essensys-hub/essensys-board-SC942C/docs_generation_prompt.md

# Prompt Template pour la Documentation Automatisée de Modules

Utilisez ce prompt pour générer la structure de documentation pour un nouveau module (ex: SC941C). Copiez-collez ce texte dans votre assistant IA, en fournissant la liste des fichiers de votre dossier.

---

**Contexte**
Je souhaite publier la documentation technique d'un nouveau module hardware (ex: `SC9xx`) pour le projet Open Source **Essensys Atrium**.
Je dispose des fichiers bruts (Export Altium, PDFs, STEP, Gerbers) dans le répertoire courant.
Mon objectif est de créer un site statique **MkDocs** (thème Material) entièrement en **Français** pour permettre aux utilisateurs de visualiser l'architecture et de télécharger les fichiers de fabrication.

**Fichiers disponibles (Input)**
*(Collez ici la liste de vos fichiers, par exemple :)*
- `Schematic PDF.pdf`
- `STEP_forSIxxxx.step`
- `Gerber for SIxxxx.zip`
- `SCxxxx` (Dossier sources)

**Tes instructions :**

1.  **Organisation des Fichiers (Assets)**
    *   Crée l'arborescence `docs/assets/` avec les sous-dossiers : `models/`, `manufacturing/`, `pdfs/`, `images/`.
    *   Renomme et déplace le fichier STEP vers `docs/assets/models/[NOM_MODULE].step`.
    *   Renomme et déplace le fichier ZIP des Gerbers vers `docs/assets/manufacturing/[NOM_MODULE]_Gerbers.zip`.
    *   Renomme et déplace les PDFs (Schéma, Assembly) vers `docs/assets/pdfs/`.
    *   Copie le PDF du schéma à la racine de `docs/assets/` sous le nom `[NOM_MODULE]_Schematic.pdf` pour un accès rapide.

2.  **Génération d'Images (Prévisualisation)**
    *   Si l'outil `pdftoppm` est disponible (ou via python), extrais les pages 2 (MCU) et 8 (Connecteurs) du PDF Schématique en PNG.
    *   Place-les dans `docs/assets/images/` (ex: `schematic_p2.png`).

3.  **Création du contenu Markdown (`docs/`)**
    *   `index.md`: Page d'accueil. Doit contenir :
        *   Une introduction "Open Source Hardware".
        *   La section "Aperçu du schéma" affichant les images générées (p2 et p8).
        *   Une liste des sections avec des émojis **Unicode** (🏛️ Architecture, 🔌 Hardware, 💾 Téléchargements).
    *   `downloads.md`: Page de téléchargements avec un tableau ou liste à cocher pour :
        *   📂 Schéma PDF
        *   📦 Modèle 3D (STEP)
        *   🏭 Fichiers de Fabrication (Gerbers ZIP)
    *   `hardware.md` et `architecture.md`: Crée les fichiers squelettes.

4.  **Documentation Firmware (`docs/firmware.md`)**
    *   Si un dossier de code source est présent (ex: `Prog/source`), analyse :
        *   `main.c`: Point d'entrée et gestion EEPROM.
        *   `hard.h` / `hard.c`: Initialisation matérielle.
        *   **`gestionentrees.c`**: Mapping des entrées (Tables `switch/case` comme `uc_EntreeTOREntreeCarte`).
        *   `slavenode.c`: Protocole de communication et vérification des données envoyées (Est-ce que les entrées sont remontées au maître ?).
    *   Crée `firmware.md` décrivant :
        *   L'environnement de build (Compilateur, MCU).
        *   La structure du projet.
        *   Le mapping mémoire (EEPROM).
        *   **Important**: Analyse et documente le **"Logical to Physical Mapping"** des entrées. Crée un tableau montrant la correspondance entre l'index logique (ex: `VAR0`) et la broche physique (ex: `RG1`). Précise si certaines entrées sont ignorées.
    *   **Diagrammes Mermaid obligatoires** :
        *   Un **Flowchart** (`graph TD`) expliquant la boucle principale et le traitement des interruptions.
        *   Un diagramme montrant le flux de traitement d'une entrée : `Bouton -> Anti-Rebond -> Stockage -> Interprétation -> Action`.
        *   *Attention à la syntaxe* : Mets des guillemets autour des labels contenant des parenthèses ou crochets (ex: `Node["Condition(1)"]`).

5.  **Configuration (`mkdocs.yml`)**
    *   Génère le fichier `mkdocs.yml` complet configuré avec le thème `material` et la structure de navigation correspondante.
    *   Ajoute la configuration `markdown_extensions` pour activer `pymdownx.superfences` et le support **Mermaid**.

6.  **Pipeline CI/CD (`.github/workflows/publish.yml`)**
    *   Crée un workflow GitHub Actions pour déployer la documentation sur GitHub Pages.
    *   Utilise `actions/setup-python`, installe `mkdocs-material` et lance `mkdocs gh-deploy --force`.

7.  **Règles Importantes**
    *   Utilise des **émojis Unicode** directs (ex: 💾) et PAS de shortcodes (ex: `:floppy_disk:`) pour éviter les problèmes de rendu.
    *   Écris tout le contenu strictement en **Français**.
    *   Vérifie bien que le support Mermaid est activé dans `mkdocs.yml`.

---
