essensys-hub/essensys-board-SC942C/docs/downloads.md

# 💾 Téléchargements

Retrouvez ici tous les fichiers de conception et de fabrication pour le module SC942C.

| Ressource | Description | Lien |
| :--- | :--- | :--- |
| **📂 Schéma PDF** | Schématique complet du module | [Télécharger (PDF)](assets/pdfs/SC942C_Schematic.pdf) |
| **📦 Modèle 3D** | Modèle STEP pour l'intégration mécanique | [Télécharger (STEP)](assets/models/SC942C.step) |
| **🏭 Gerbers** | Fichiers de fabrication pour PCB | [Télécharger (ZIP)](assets/manufacturing/SC942C_Gerbers.zip) |
| **📄 Plan d'assemblage** | Dessin d'assemblage des composants | [Télécharger (PDF)](assets/pdfs/SC942C_Assembly.pdf) |
