essensys-hub/essensys-board-SC942C/docs/index.md

# Documentation SC942C

Bienvenue sur la documentation du module **SC942C**.

Ce projet s'inscrit dans la démarche **Open Source Hardware** du projet **Essensys Atrium**.

## Aperçu du schéma

Voici un aperçu de l'architecture électronique du module (Extraits).

### Microcontrôleur (MCU)
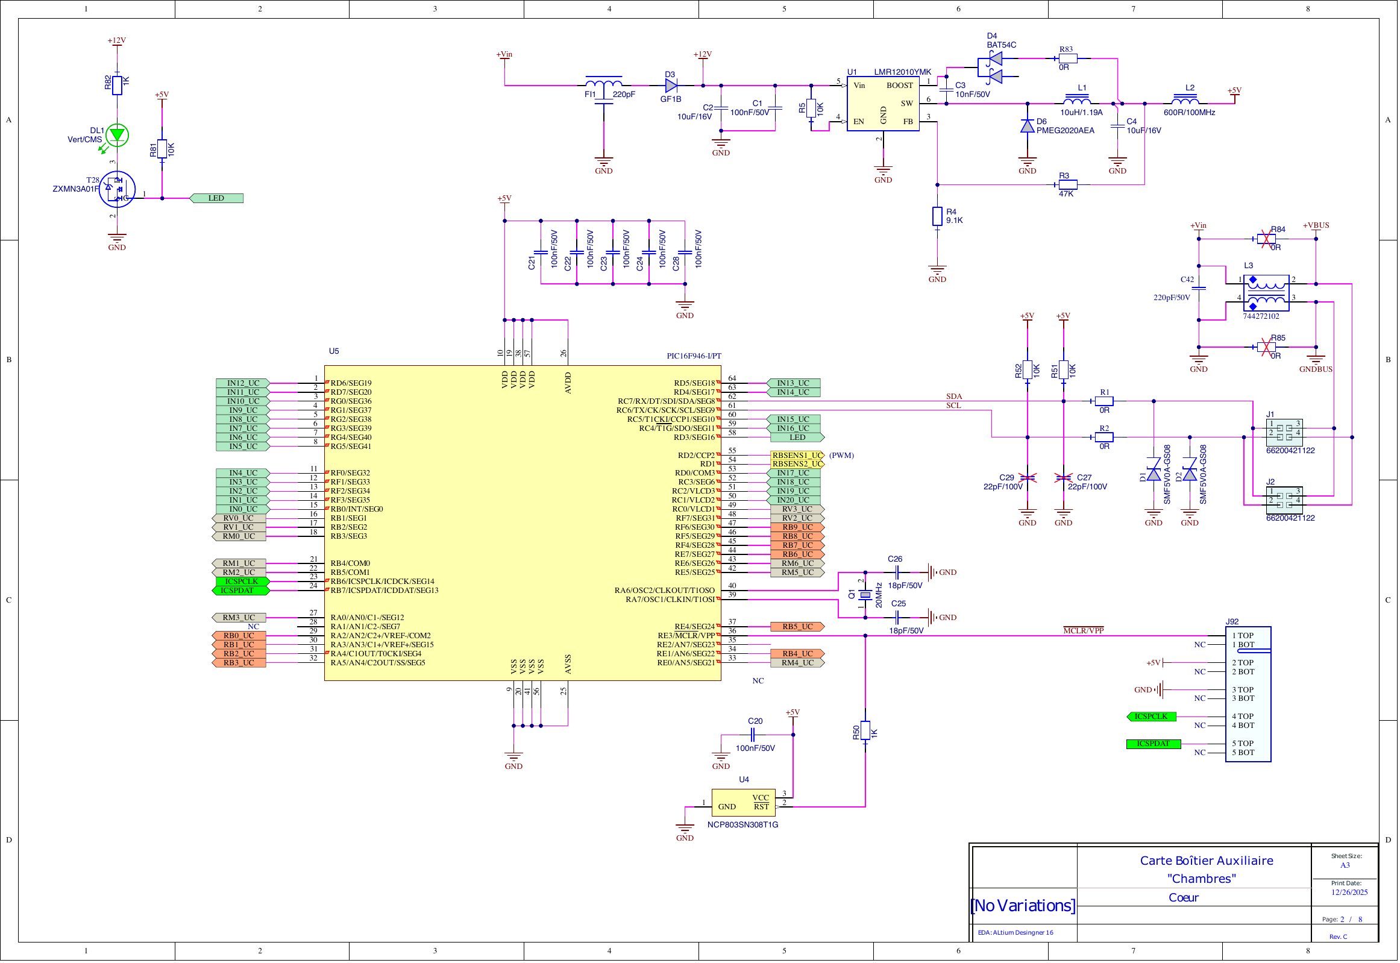
[picture p1: docs/assets/images/schematic_p2.png]
MCU Preview


### Connecteurs
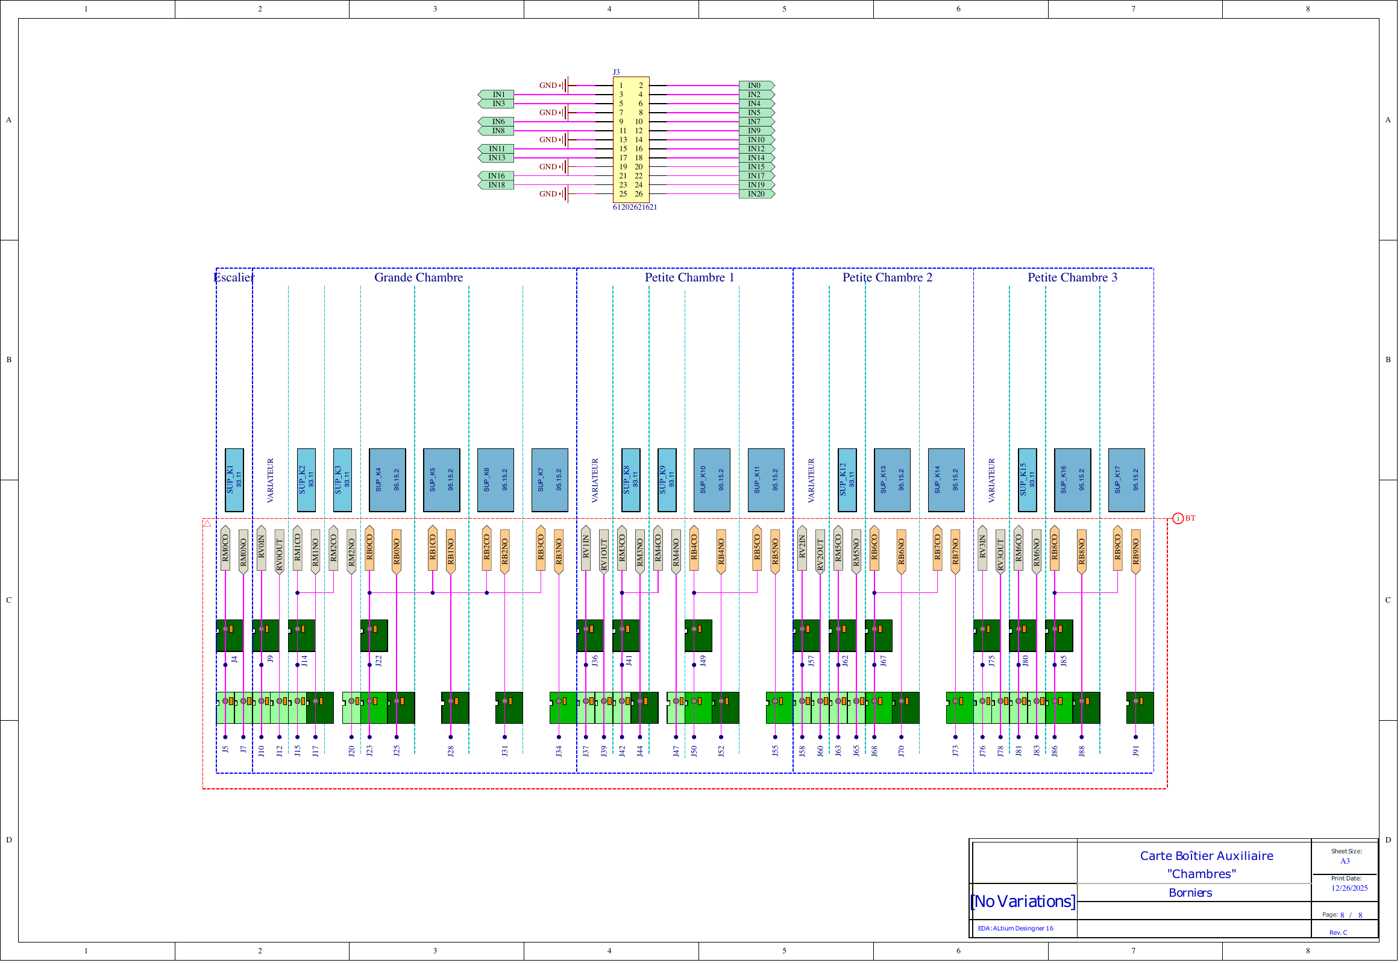
[picture p2: docs/assets/images/schematic_p8.png]
Connectors Preview


## Contenu

*   **[🏛️ Architecture](architecture.md)** : Vue d'ensemble du fonctionnement.
*   **[🔌 Hardware](hardware.md)** : Détails techniques et composants.
*   **[⚙️ Firmware](firmware.md)** : Documentation du code embarqué.
*   **[💾 Téléchargements](downloads.md)** : Fichiers sources (Gerbers, STEP, PDF).
