essensys-hub/essensys-board-SC942C/docs/assets/images/schematic_page-3.png

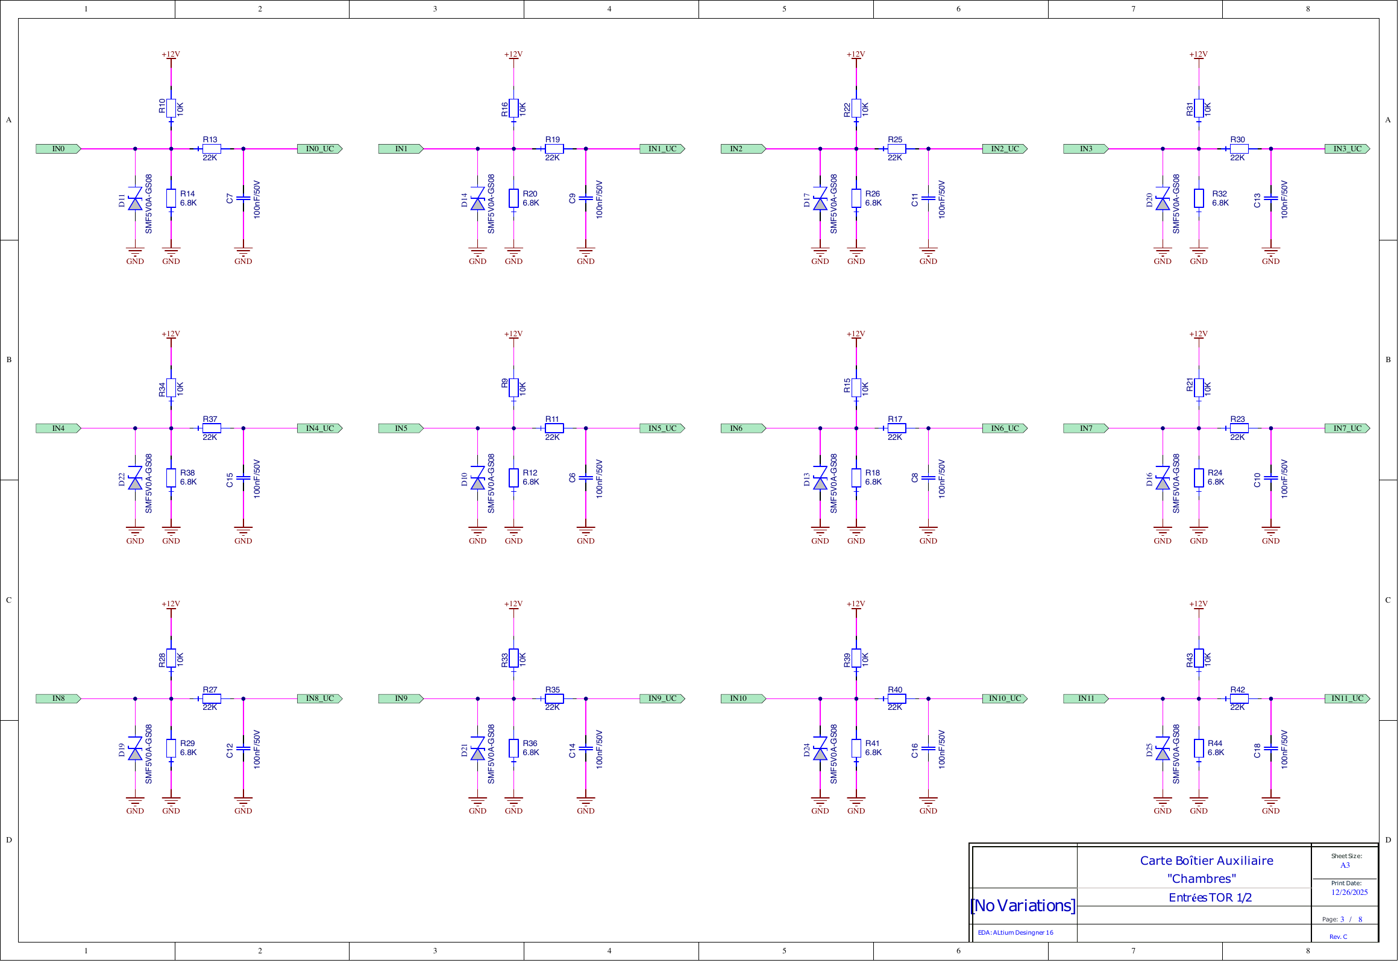
docs/assets/images/schematic_page-3.png
