essensys-hub/essensys-board-SC942C/docs/assets/images/schematic_page-7.png

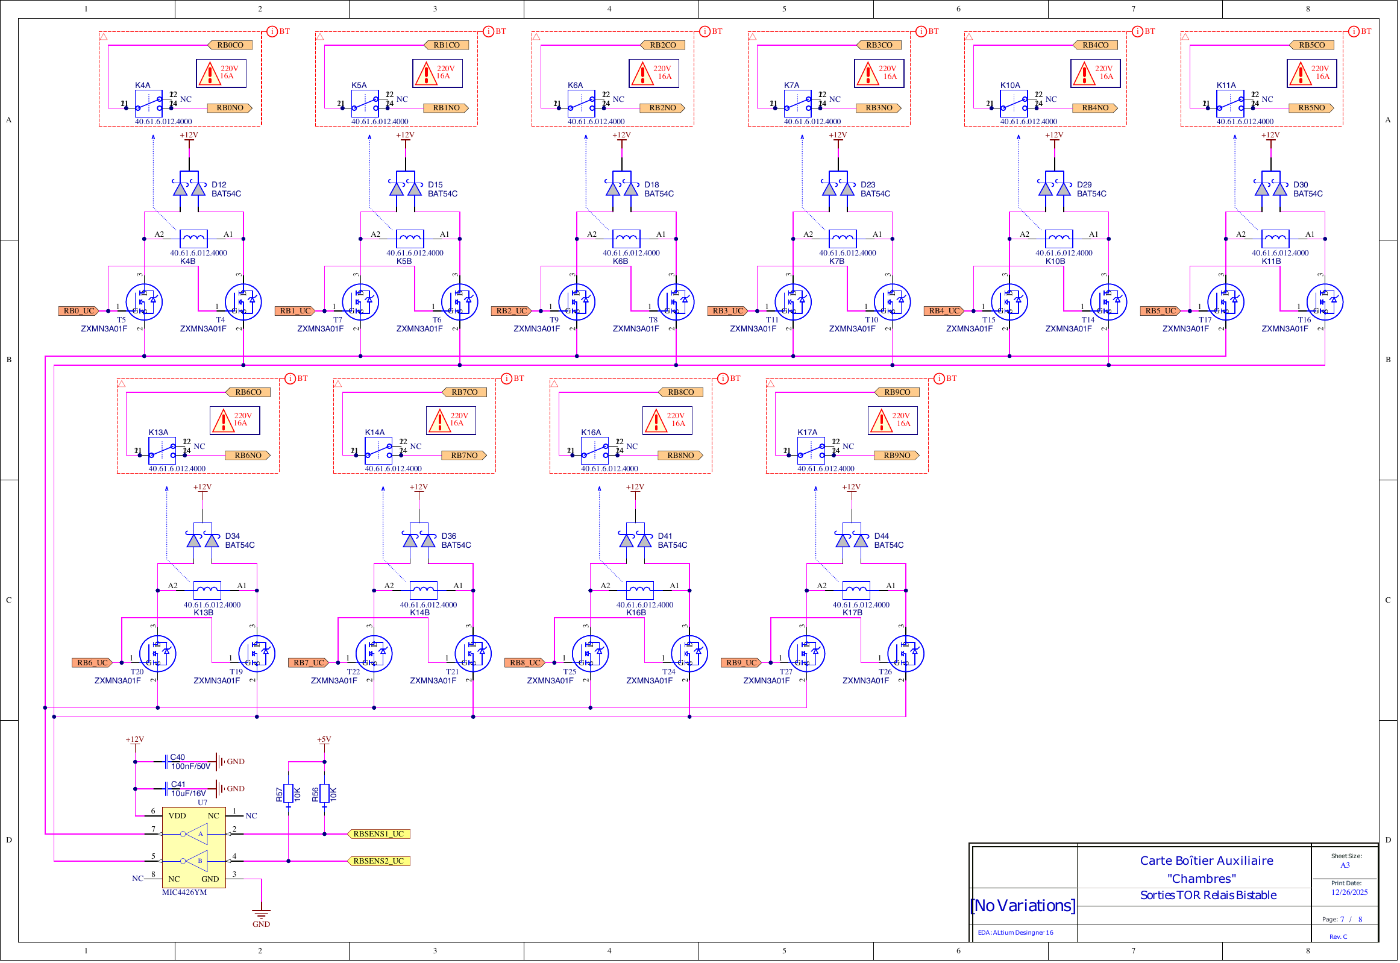
docs/assets/images/schematic_page-7.png
