essensys-hub/essensys-board-SC942C/SC942C/Assembly/SC942C_BOM_Format‚ (DM).xlsx

Description | Fabricant | Ref Fab | Value | Quantity | Designator | Footprint
Circuit imprimé | Valentinéa | SI942C | SI942C | 1 | SI1 | CIRCUIT_IMPRIME_SI_STD
Carte gradateur | Valentinéa | SC943D | - | 4 | U2, U3, U6, U8 | SI943C_REV_A
Résistance CMS 0805, 0.125W, 1%, 100ppm, 150V | Vishay | CRCW08050000Z0EA | 0R | 5 | R1, R2, R83, R84, R85 | 0805_ReflowSoldering_RES
Résistance CMS 0805, 0.125W, 1%, 100ppm, 150V | Vishay | CRCW08051K00FKEA | 1K | 2 | R50, R82 | 0805_ReflowSoldering_RES
Résistance CMS 0805, 0.125W, 1%, 100ppm, 150V | Vishay | CRCW08052K20FKEA | 2.2K | 2 | R75, R78 | 0805_ReflowSoldering_RES
Résistance CMS 0805, 0.125W, 1%, 100ppm, 150V | Vishay | CRCW08056K80FKEA | 6.8K | 21 | R12, R14, R18, R20, R24, R26, R29, R32, R36, R38, R41, R44, R49, R54, R60, R63, R66, R69, R72, R76, R79 | 0805_ReflowSoldering_RES
Résistance CMS 0805, 0.125W, 1%, 100ppm, 150V | Vishay | CRCW08059K10FKEA | 9.1K | 1 | R4 | 0805_ReflowSoldering_RES
Résistance CMS 0805, 0.125W, 1%, 100ppm, 150V | Vishay | CRCW080510K0FKEA | 10K | 34 | R5, R6, R7, R8, R9, R10, R15, R16, R21, R22, R28, R31, R33, R34, R39, R43, R45, R46, R47, R51, R52, R55, R56, R57, R58, R61, R64, R67, R70, R73, R74, R77, R80, R81 | 0805_ReflowSoldering_RES
Résistance CMS 0805, 0.125W, 1%, 100ppm, 150V | Vishay | CRCW080522K0FKEA | 22K | 19 | R11, R13, R17, R19, R23, R25, R27, R30, R35, R37, R40, R42, R48, R53, R59, R62, R65, R68, R71 | 0805_ReflowSoldering_RES
Résistance CMS 0805, 0.125W, 1%, 100ppm, 150V | Vishay | CRCW080547K0FKEA | 47K | 1 | R3 | 0805_ReflowSoldering_RES
Condensateur céramique, NPO, 5%, CMS 0603 | Kemet | C0603C180J5GAC | 18pF/50V | 2 | C25, C26 | 0603_ReflowSoldering_CAP
Condensateur céramique, X7R, 10%, CMS 0603 | Kemet | C0603C103K5RAC | 10nF/50V | 1 | C3 | 0603_ReflowSoldering_CAP
Condensateur céramique, X7R, 10%, CMS 0805 | Kemet | C0805C104K5RAC | 100nF/50V | 33 | C1, C5, C6, C7, C8, C9, C10, C11, C12, C13, C14, C15, C16, C17, C18, C19, C20, C21, C22, C23, C24, C28, C30, C31, C32, C33, C34, C35, C36, C37, C38, C39, C40 | 0805_ReflowSoldering_CAP
Condensateur céramique, X5R, 10%, CMS 0805 | Kemet | C0805C106K4PAC | 10uF/16V | 3 | C2, C4, C41 | 0805_ReflowSoldering_CAP
Inductance bobinée CMS, 10uH +/- 10%, I=1.19A, Rdc=0.095R, SRF=40MHz, -40/+85°C | Wurth Elektronik | 744043100 | 10uH/1,19A | 1 | L1 | SELF_WE-TPC_4.8x4.78_(type4828)
Ferrite multicouches CMS, imp=600R@100MHz, +/-25%, Rdc=100mR, I=2A | Wurth Elektronik | 74279218 | 600R/100MHz | 1 | L2 | 1206_ReflowSoldering_FERRITE
Filtre EMI selfique-capacitif, -20/+50%, 25Vcc/6A, -40/+85°C | Murata | NFE31PT221D1E9L | 220pF | 1 | FI1 | NFE31P
Quartz CMS série HCM49 (équiv HC49/US), -10/+60°C, +/-30ppm, 18pF | Citizen | HCM49 20.000MABJ-UT | 20MHz | 1 | Q1 | QUARTZ_HC49_11.5X5_CMS
Diode de Redressement, Vrrm=100V, If=1A, Vf=1.1V, CMS | Fairchild | GF1B | - | 1 | D3 | DO214BA-P
Diode Schottky double, BAT54 cathode com, Vrrm=30V, If=300mA, Vf=0.4Vmax, CMS | NXP | BAT54C | - | 18 | D4, D7, D8, D9, D12, D15, D18, D23, D26, D28, D29, D30, D32, D34, D36, D40, D41, D44 | SOT23_3L_ReflowSoldering
Diode Schottky, Vrrm=20V, If=2A, Vf=450mV, CMS | NXP | PMEG2020AEA | - | 1 | D6 | SOD323_ReflowSoldering
Diode Transil/TVS unidirectionnelle (A), 200W, 5V, CMS | Vishay | SMF5V0A | - | 23 | D1, D2, D10, D11, D13, D14, D16, D17, D19, D20, D21, D22, D24, D25, D27, D31, D33, D35, D37, D38, D39, D42, D43 | DO219AB-SMF-P_ReflowSoldering
Varistance disque 275Vac, 350Vdc, 33J, Vbreak=430V@1mA, Vclamp=710V@10A, Ipeak=1200A | Wurth Elektronik | 820572711 | 710V | 4 | VR1, VR2, VR3, VR4 | VDR_Serie_820_d7_h13_e5mm
~~LED vert, Vf 2V@20mA, 40mCd, vue 140°, CMS 0805~~ LED vert, Vf 2,2V@20mA, 12mCd, vue 120°, CMS 0805 | ~~Wurth Elektronik~~ Kingbright | ~~150080VS75000~~ KP2012-SGC | - | 1 | DL1 | LED_0805_KPx_Green
Transistor MOSN logique, Vdss=30V, Id=2A, Rdson=0.12R, CMS | Zetex | ZXMN3A01F | - | 28 | T1, T2, T3, T4, T5, T6, T7, T8, T9, T10, T11, T12, T13, T14, T15, T16, T17, T18, T19, T20, T21, T22, T23, T24, T25, T26, T27, T28 | SOT23_3L_ReflowSoldering
Régulateur ajustable step down, 0.8~20V, 1A, Vin=3~20V, -40/+125°C, CMS | National Semiconductor | LMR12010YMK | - | 1 | U1 | SOT23_6L
Superviseur de Reset pour microcontrolleur 3.08V -Pin SOT-23, CMS | ON | NCP803SN308T1G | - | 1 | U4 | SOT23_3L_ReflowSoldering
Dual High-Speed 1.5A MOSFET Driver, CMS | Micrel | MIC4426YM | - | 1 | U7 | SOIC_08_E1,27_L150_ReflowSoldering
Microcontrôleur 8bit | Microchip | PIC16F946-I/PT | - | 1 | U5 | QFP_064_E0,50_10X10MM
Relais 1RT, 12Vdc, série 34.51, Rc=1940R, Sw:250Vac/6A, Ron=? (AgSnO2) | Finder | 34.51.7.012.4010 | - | 7 | K1, K2, K3, K8, K9, K12, K15 | RELAY_FINDER_34.51_+SUPPORT_93
Relais 1RT, 12Vdc, série 40.61.6 (bistable), Rc=900R, Sw:250Vac/16A, Ron=? (AgSnO2) | Finder | 40.61.6.012.4000 | - | 10 | K4, K5, K6, K7, K10, K11, K13, K14, K16, K17 | RELAY_FINDER_40.61_+SUPPORT_95
Suppor série 93 pour relais Finder séries 34, 250V/6A, Bleu | Finder | 93.11 | - | 7 | SUP_K1, SUP_K2, SUP_K3, SUP_K8, SUP_K9, SUP_K12, SUP_K15 | RELAY-SUPPORT_FINDER_SERIE93
Suppor série 95 pour relais Finder séries 40, 250V/10A, Bleu, sans Etrier | Finder | 95.15.2 SMA | - | 10 | SUP_K4, SUP_K5, SUP_K6, SUP_K7, SUP_K10, SUP_K11, SUP_K13, SUP_K14, SUP_K16, SUP_K17 | RELAY-SUPPORT_FINDER_SERIE95
Bornier à connexion par ressorts/déconnexion par levier, série FFKDS/V2, e5.08, 1x1pts, droit, juxtaposable, 320V/15A, AWG22~16, Vert/Orange | Phoenix Contact | 1790348 | - | 18 | J5, J7, J10, J12, J15, J20, J37, J39, J42, J47, J58, J60, J63, J65, J76, J78, J81, J83 | BRESS_FFKDS/V2-5,08_P1.3
Bornier à connexion par ressorts/déconnexion par levier, série FFKDSA/V2, e7.62, 1x1pts, droit, juxtaposable, 500V/17.5A, AWG22~16, Vert/Orange | Phoenix Contact | 1790377 | - | 7 | J23, J34, J50, J55, J68, J73, J86 | BRESS_FFKDSA/V2-7,62_P1.3
Bornier à connexion par ressorts/déconnexion par levier, série FFKDSA1/V2, e7.62, 1x1pts, droit, terminaison, 500V/17.5A, AWG22~16, Vert/Orange | Phoenix Contact | 1790487 | - | 22 | J4, J9, J14, J17, J22, J25, J28, J31, J36, J41, J44, J49, J52, J57, J62, J67, J70, J75, J80, J85, J88, J91 | BRESS_FFKDSA1/V2-7,62_P1.3
26 Positions Header, Shrouded Connector 0.100" (2.54mm) Through Hole Gold | Wurth Elektronik | 61202621621 | - | 1 | J3 | IDC2P54_26P
Embase type Micro Mate-n-Lok, e3mm, 4pts, droit, cont. étamés 20mR, 250V/5A, Iso 1500V, -40/+105°C | Wurth Elektronik | 66200421122 | - | 2 | J1, J2 | MICRO-MATE-N-LOK_WURTH+TYCO_2X02_D
