essensys-hub/essensys-board-SC942C/(list of files, cad)

Other CAD files:
SC942C/3D/SC942C/SUP_K14.sldasm
SC942C/3D/SC942C/C21.sldasm
SC942C/3D/SC942C/C7_1.sldasm
SC942C/3D/SC942C/D14.sldasm
SC942C/3D/SC942C/R11.sldasm
SC942C/3D/SC942C/D39.sldasm
SC942C/3D/SC942C/D35.sldasm
SC942C/3D/SC942C/D26.sldasm
SC942C/3D/SC942C/K12.sldasm
SC942C/3D/SC942C/C37.sldasm
SC942C/3D/SC942C/R28.sldasm
SC942C/3D/SC942C/C11.sldasm
SC942C/3D/SC942C/U1.sldasm
SC942C/3D/SC942C/R73.sldasm
SC942C/3D/SC942C/C29.sldasm
SC942C/3D/SC942C/C26.sldasm
SC942C/3D/SC942C/J57.sldasm
SC942C/3D/SC942C/R76.sldasm
SC942C/3D/SC942C/R70.sldasm
SC942C/3D/SC942C/T18.sldasm
SC942C/3D/SC942C/J5.sldasm
SC942C/3D/SC942C/T3_1.sldasm
SC942C/3D/SC942C/J50.sldasm
SC942C/3D/SC942C/R57.sldasm
SC942C/3D/SC942C/R6.sldasm
SC942C/3D/SC942C/J73.sldasm
SC942C/3D/SC942C/J49.sldasm
SC942C/3D/SC942C/T10.sldasm
SC942C/3D/SC942C/J34.sldasm
SC942C/3D/SC942C/T1.sldasm
SC942C/3D/SC942C/R4.sldasm
SC942C/3D/SC942C/R16.sldasm
SC942C/3D/SC942C/J28.sldasm
SC942C/3D/SC942C/T19.sldasm
SC942C/3D/SC942C/K1.sldasm
SC942C/3D/SC942C/R64.sldasm
SC942C/3D/SC942C/D30.sldasm
SC942C/3D/SC942C/R62.sldasm
SC942C/3D/SC942C/D19.sldasm
SC942C/3D/SC942C/C15.sldasm
SC942C/3D/SC942C/T4.sldasm
SC942C/3D/SC942C/SUP_K6.sldasm
SC942C/3D/SC942C/C42.sldasm
SC942C/3D/SC942C/U1_1.sldasm
SC942C/3D/SC942C/T15.sldasm
SC942C/3D/SC942C/T6.sldasm
SC942C/3D/SC942C/R74.sldasm
SC942C/3D/SC942C/D15.sldasm
SC942C/3D/SC942C/R37.sldasm
SC942C/3D/SC942C/T22.sldasm
SC942C/3D/SC942C/T27.sldasm
SC942C/3D/SC942C/J25.sldasm
SC942C/3D/SC942C/R26.sldasm
SC942C/3D/SC942C/C2.sldasm
SC942C/3D/SC942C/R33.sldasm
SC942C/3D/SC942C/D25.sldasm
SC942C/3D/SC942C/J7.sldasm
SC942C/3D/SC942C/R56.sldasm
SC942C/3D/SC942C/C36.sldasm
SC942C/3D/SC942C/VR2.sldasm
SC942C/3D/SC942C/VR3.sldasm
SC942C/3D/SC942C/R11_1.sldasm
SC942C/3D/SC942C/K11.sldasm
SC942C/3D/SC942C/J10.sldasm
SC942C/3D/SC942C/C27.sldasm
SC942C/3D/SC942C/L2.sldasm
SC942C/3D/SC942C/T21.sldasm
SC942C/3D/SC942C/D36.sldasm
SC942C/3D/SC942C/J86.sldasm
SC942C/3D/SC942C/C10.sldasm
SC942C/3D/SC942C/R55.sldasm
SC942C/3D/SC942C/J91.sldasm
SC942C/3D/SC942C/R77.sldasm
SC942C/3D/SC942C/J36.sldasm
SC942C/3D/SC942C/D6_1.sldasm
SC942C/3D/SC942C/D3.sldasm
SC942C/3D/SC942C/C17.sldasm
SC942C/3D/SC942C/R83.sldasm
SC942C/3D/SC942C/T7.sldasm
SC942C/3D/SC942C/J42.sldasm
SC942C/3D/SC942C/D34.sldasm
SC942C/3D/SC942C/R18_1.sldasm
SC942C/3D/SC942C/D22.sldasm
SC942C/3D/SC942C/D20.sldasm
SC942C/3D/SC942C/R31.sldasm
SC942C/3D/SC942C/SUP_K10.sldasm
SC942C/3D/SC942C/R20.sldasm
SC942C/3D/SC942C/T12.sldasm
SC942C/3D/SC942C/C40.sldasm
SC942C/3D/SC942C/T25.sldasm
SC942C/3D/SC942C/R84.sldasm
SC942C/3D/SC942C/C8.sldasm
SC942C/3D/SC942C/Q1.sldasm
SC942C/3D/SC942C/J17.sldasm
SC942C/3D/SC942C/STEP-61202621621-rev1.sldasm
SC942C/3D/SC942C/J68.sldasm
SC942C/3D/SC942C/J81.sldasm
SC942C/3D/SC942C/J23.sldasm
SC942C/3D/SC942C/T28.sldasm
SC942C/3D/SC942C/R43.sldasm
SC942C/3D/SC942C/K10.sldasm
SC942C/3D/SC942C/T2.sldasm
SC942C/3D/SC942C/R42.sldasm
SC942C/3D/SC942C/K9.sldasm
SC942C/3D/SC942C/R25.sldasm
SC942C/3D/SC942C/C5.sldasm
SC942C/3D/SC942C/R80.sldasm
SC942C/3D/SC942C/R48.sldasm
SC942C/3D/SC942C/K17.sldasm
SC942C/3D/SC942C/J4.sldasm
SC942C/3D/SC942C/K5.sldasm
SC942C/3D/SC942C/R41.sldasm
SC942C/3D/SC942C/T5_1.sldasm
SC942C/3D/SC942C/R23.sldasm
SC942C/3D/SC942C/K14.sldasm
SC942C/3D/SC942C/D12.sldasm
SC942C/3D/SC942C/R22.sldasm
SC942C/3D/SC942C/VR1.sldasm
SC942C/3D/SC942C/D9.sldasm
SC942C/3D/SC942C/R82.sldasm
SC942C/3D/SC942C/C14.sldasm
SC942C/3D/SC942C/D17.sldasm
SC942C/3D/SC942C/D37.sldasm
SC942C/3D/SC942C/D42.sldasm
SC942C/3D/SC942C/C23.sldasm
SC942C/3D/SC942C/User_Library-SOIC-8-150.sldasm
SC942C/3D/SC942C/J88.sldasm
SC942C/3D/SC942C/J41.sldasm
SC942C/3D/SC942C/J76.sldasm
SC942C/3D/SC942C/R2.sldasm
SC942C/3D/SC942C/D13.sldasm
SC942C/3D/SC942C/T26.sldasm
SC942C/3D/SC942C/R21.sldasm
SC942C/3D/SC942C/D24.sldasm
SC942C/3D/SC942C/D10.sldasm
SC942C/3D/SC942C/C34.sldasm
SC942C/3D/SC942C/R79.sldasm
SC942C/3D/SC942C/J12.sldasm
SC942C/3D/SC942C/R58.sldasm
SC942C/3D/SC942C/R7.sldasm
SC942C/3D/SC942C/U6.sldasm
SC942C/3D/SC942C/T5.sldasm
SC942C/3D/SC942C/K6.sldasm
SC942C/3D/SC942C/R49.sldasm
SC942C/3D/SC942C/STEP-744272102-rev1_RGB8421504.sldasm
SC942C/3D/SC942C/R67.sldasm
SC942C/3D/SC942C/SUP_K11.sldasm
SC942C/3D/SC942C/R19.sldasm
SC942C/3D/SC942C/R13.sldasm
SC942C/3D/SC942C/K4.sldasm
SC942C/3D/SC942C/1151710376.sldasm
SC942C/3D/SC942C/1151710512.sldasm
SC942C/3D/SC942C/1151724792.sldasm
SC942C/3D/SC942C/1151724928.sldasm
SC942C/3D/SC942C/1151725064.sldasm
SC942C/3D/SC942C/1790348.sldasm
SC942C/3D/SC942C/1790377.sldasm
SC942C/3D/SC942C/1790487.sldasm
SC942C/3D/SC942C/61202621621.sldprt
SC942C/3D/SC942C/6120xx21621_PIN.sldprt
SC942C/3D/SC942C/905269392.sldasm
SC942C/3D/SC942C/905269800.sldasm
SC942C/3D/SC942C/Base.sldprt
SC942C/3D/SC942C/Base_4.sldprt
SC942C/3D/SC942C/Base_6.sldprt
SC942C/3D/SC942C/Board.sldprt
SC942C/3D/SC942C/Board_1.sldprt
SC942C/3D/SC942C/C1.sldasm
SC942C/3D/SC942C/C12.sldasm
SC942C/3D/SC942C/C13.sldasm
SC942C/3D/SC942C/C16.sldasm
SC942C/3D/SC942C/C18.sldasm
SC942C/3D/SC942C/C19.sldasm
SC942C/3D/SC942C/C1_1.sldasm
SC942C/3D/SC942C/C20.sldasm
SC942C/3D/SC942C/C22.sldasm
SC942C/3D/SC942C/C24.sldasm
SC942C/3D/SC942C/C25.sldasm
SC942C/3D/SC942C/C28.sldasm
SC942C/3D/SC942C/C2_1.sldasm
SC942C/3D/SC942C/C3.sldasm
SC942C/3D/SC942C/C30.sldasm
SC942C/3D/SC942C/C31.sldasm
SC942C/3D/SC942C/C32.sldasm
SC942C/3D/SC942C/C33.sldasm
SC942C/3D/SC942C/C35.sldasm
SC942C/3D/SC942C/C38.sldasm
SC942C/3D/SC942C/C39.sldasm
SC942C/3D/SC942C/C3_1.sldasm
SC942C/3D/SC942C/C4.sldasm
SC942C/3D/SC942C/C41.sldasm
SC942C/3D/SC942C/C4_1.sldasm
SC942C/3D/SC942C/C5_1.sldasm
SC942C/3D/SC942C/C6.sldasm
SC942C/3D/SC942C/C6_1.sldasm
SC942C/3D/SC942C/C7.sldasm
SC942C/3D/SC942C/C8_1.sldasm
SC942C/3D/SC942C/C9.sldasm
SC942C/3D/SC942C/C9_1.sldasm
SC942C/3D/SC942C/Contact.sldprt
SC942C/3D/SC942C/Coque_inf‚rieure_commune_BA+BP_v3.0_(Valla).sldprt
SC942C/3D/SC942C/Coque_sup‚rieure_BA_CHB_(942)_v2.0_(Valla).sldprt
SC942C/3D/SC942C/D1.sldasm
SC942C/3D/SC942C/D11.sldasm
SC942C/3D/SC942C/D16.sldasm
SC942C/3D/SC942C/D18.sldasm
SC942C/3D/SC942C/D1_1.sldasm
SC942C/3D/SC942C/D2.sldasm
SC942C/3D/SC942C/D21.sldasm
SC942C/3D/SC942C/D23.sldasm
SC942C/3D/SC942C/D27.sldasm
SC942C/3D/SC942C/D28.sldasm
SC942C/3D/SC942C/D29.sldasm
SC942C/3D/SC942C/D2_1.sldasm
SC942C/3D/SC942C/D31.sldasm
SC942C/3D/SC942C/D32.sldasm
SC942C/3D/SC942C/D33.sldasm
SC942C/3D/SC942C/D38.sldasm
SC942C/3D/SC942C/D3_1.sldasm
SC942C/3D/SC942C/D4.sldasm
SC942C/3D/SC942C/D40.sldasm
SC942C/3D/SC942C/D41.sldasm
SC942C/3D/SC942C/D43.sldasm
SC942C/3D/SC942C/D44.sldasm
SC942C/3D/SC942C/D4_1.sldasm
SC942C/3D/SC942C/D5.sldasm
SC942C/3D/SC942C/D6.sldasm
SC942C/3D/SC942C/D7.sldasm
SC942C/3D/SC942C/D7_1.sldasm
SC942C/3D/SC942C/D8.sldasm
SC942C/3D/SC942C/DL1.sldasm
SC942C/3D/SC942C/Extruded.sldprt
SC942C/3D/SC942C/Extruded_1.sldprt
SC942C/3D/SC942C/Extruded_2.sldprt
SC942C/3D/SC942C/Extruded_3.sldprt
SC942C/3D/SC942C/Extruded_4.sldprt
SC942C/3D/SC942C/Extruded_5.sldprt
SC942C/3D/SC942C/Extruded_6.sldprt
SC942C/3D/SC942C/Free-Models.sldasm
SC942C/3D/SC942C/J1.sldasm
SC942C/3D/SC942C/J14.sldasm
SC942C/3D/SC942C/J15.sldasm
SC942C/3D/SC942C/J2.sldasm
SC942C/3D/SC942C/J20.sldasm
SC942C/3D/SC942C/J22.sldasm
SC942C/3D/SC942C/J3.sldasm
SC942C/3D/SC942C/J31.sldasm
SC942C/3D/SC942C/J37.sldasm
SC942C/3D/SC942C/J39.sldasm
SC942C/3D/SC942C/J44.sldasm
SC942C/3D/SC942C/J47.sldasm
SC942C/3D/SC942C/J52.sldasm
SC942C/3D/SC942C/J55.sldasm
SC942C/3D/SC942C/J58.sldasm
SC942C/3D/SC942C/J60.sldasm
SC942C/3D/SC942C/J62.sldasm
SC942C/3D/SC942C/J63.sldasm
SC942C/3D/SC942C/J65.sldasm
SC942C/3D/SC942C/J67.sldasm
SC942C/3D/SC942C/J70.sldasm
SC942C/3D/SC942C/J75.sldasm
SC942C/3D/SC942C/J78.sldasm
SC942C/3D/SC942C/J80.sldasm
SC942C/3D/SC942C/J83.sldasm
SC942C/3D/SC942C/J85.sldasm
SC942C/3D/SC942C/J9.sldasm
SC942C/3D/SC942C/K13.sldasm
SC942C/3D/SC942C/K15.sldasm
SC942C/3D/SC942C/K16.sldasm
SC942C/3D/SC942C/K2.sldasm
SC942C/3D/SC942C/K3.sldasm
SC942C/3D/SC942C/K7.sldasm
SC942C/3D/SC942C/K8.sldasm
SC942C/3D/SC942C/L1.sldasm
SC942C/3D/SC942C/L1_1.sldasm
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
