essensys-hub/essensys-board-SC942C/SC942C/Test/Sources/10 - 20170313_111045.jpg

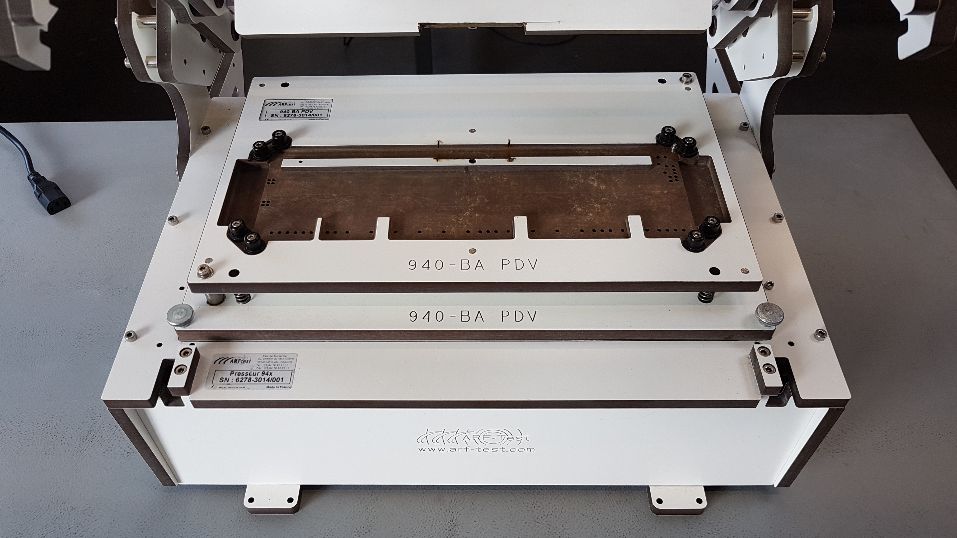
SC942C/Test/Sources/10 - 20170313_111045.jpg
