essensys-hub/essensys-board-SC942C/SC942C/Test/Sources/20 - 20170313_110935.jpg

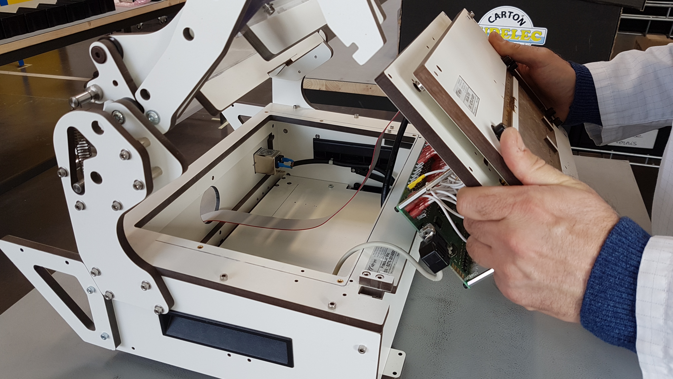
SC942C/Test/Sources/20 - 20170313_110935.jpg
