essensys-hub/essensys-board-SC942C/SC942C/Test/Sources/30 - 20170313_105927.jpg

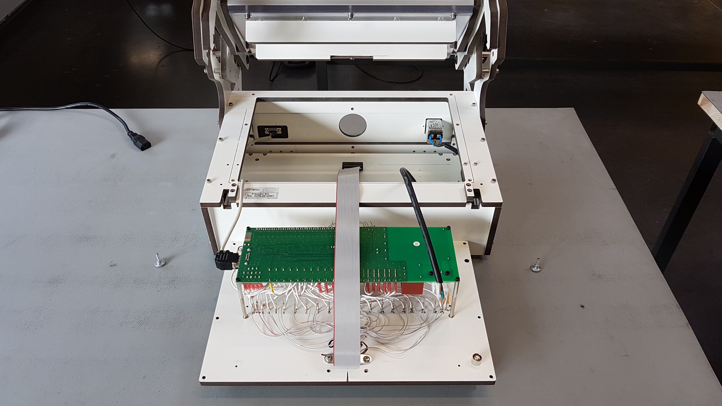
SC942C/Test/Sources/30 - 20170313_105927.jpg
