essensys-hub/essensys-board-SC942C/SC942C/Test/Sources/40 - 20170313_112822.jpg

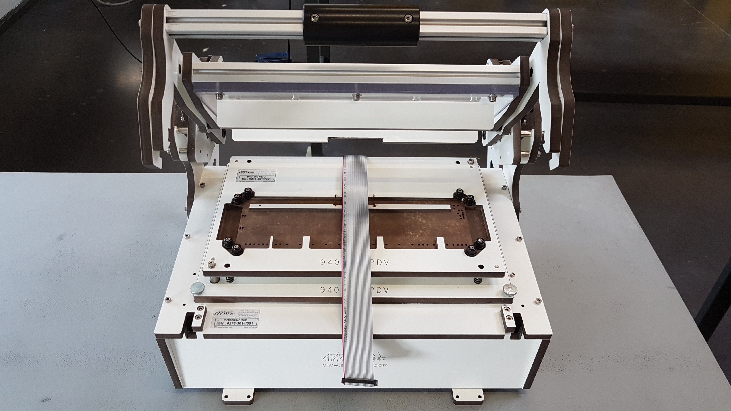
SC942C/Test/Sources/40 - 20170313_112822.jpg
