essensys-hub/essensys-board-SC942C/SC942C/Test/Sources/60 - 20170313_120900.jpg

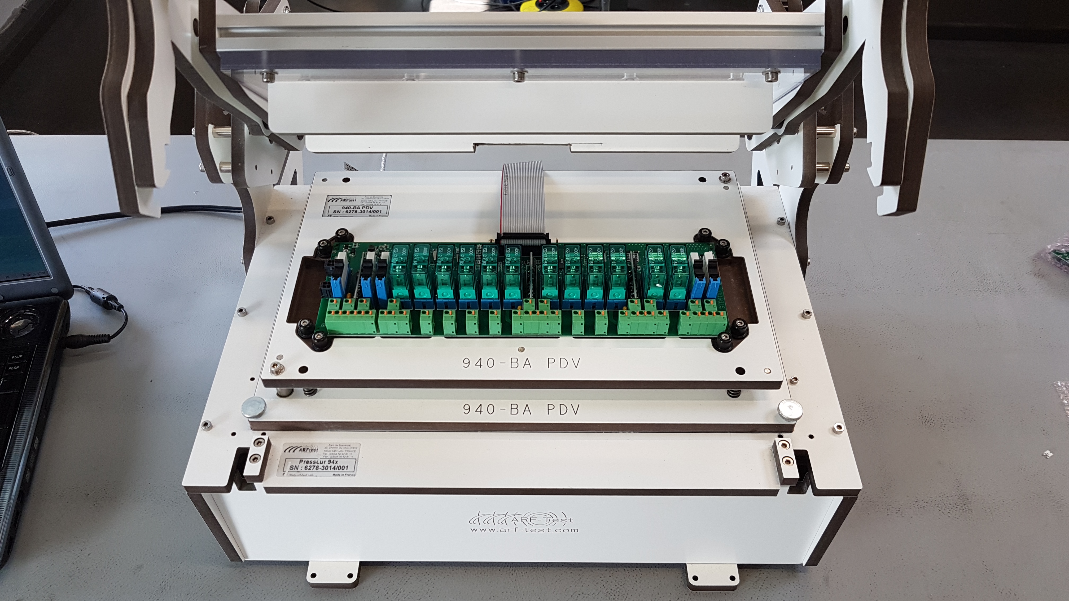
SC942C/Test/Sources/60 - 20170313_120900.jpg
