essensys-hub/essensys-board-SC942C/SC942C/Test/Sources/70 - 20170313_121427.jpg

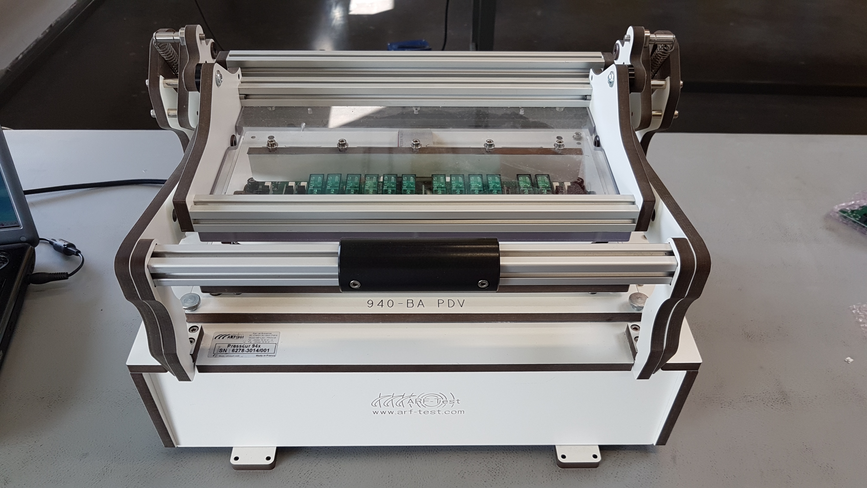
SC942C/Test/Sources/70 - 20170313_121427.jpg
