essensys-hub/essensys-board-SC942C/docs/assets/SC942C_Schematic.pdf

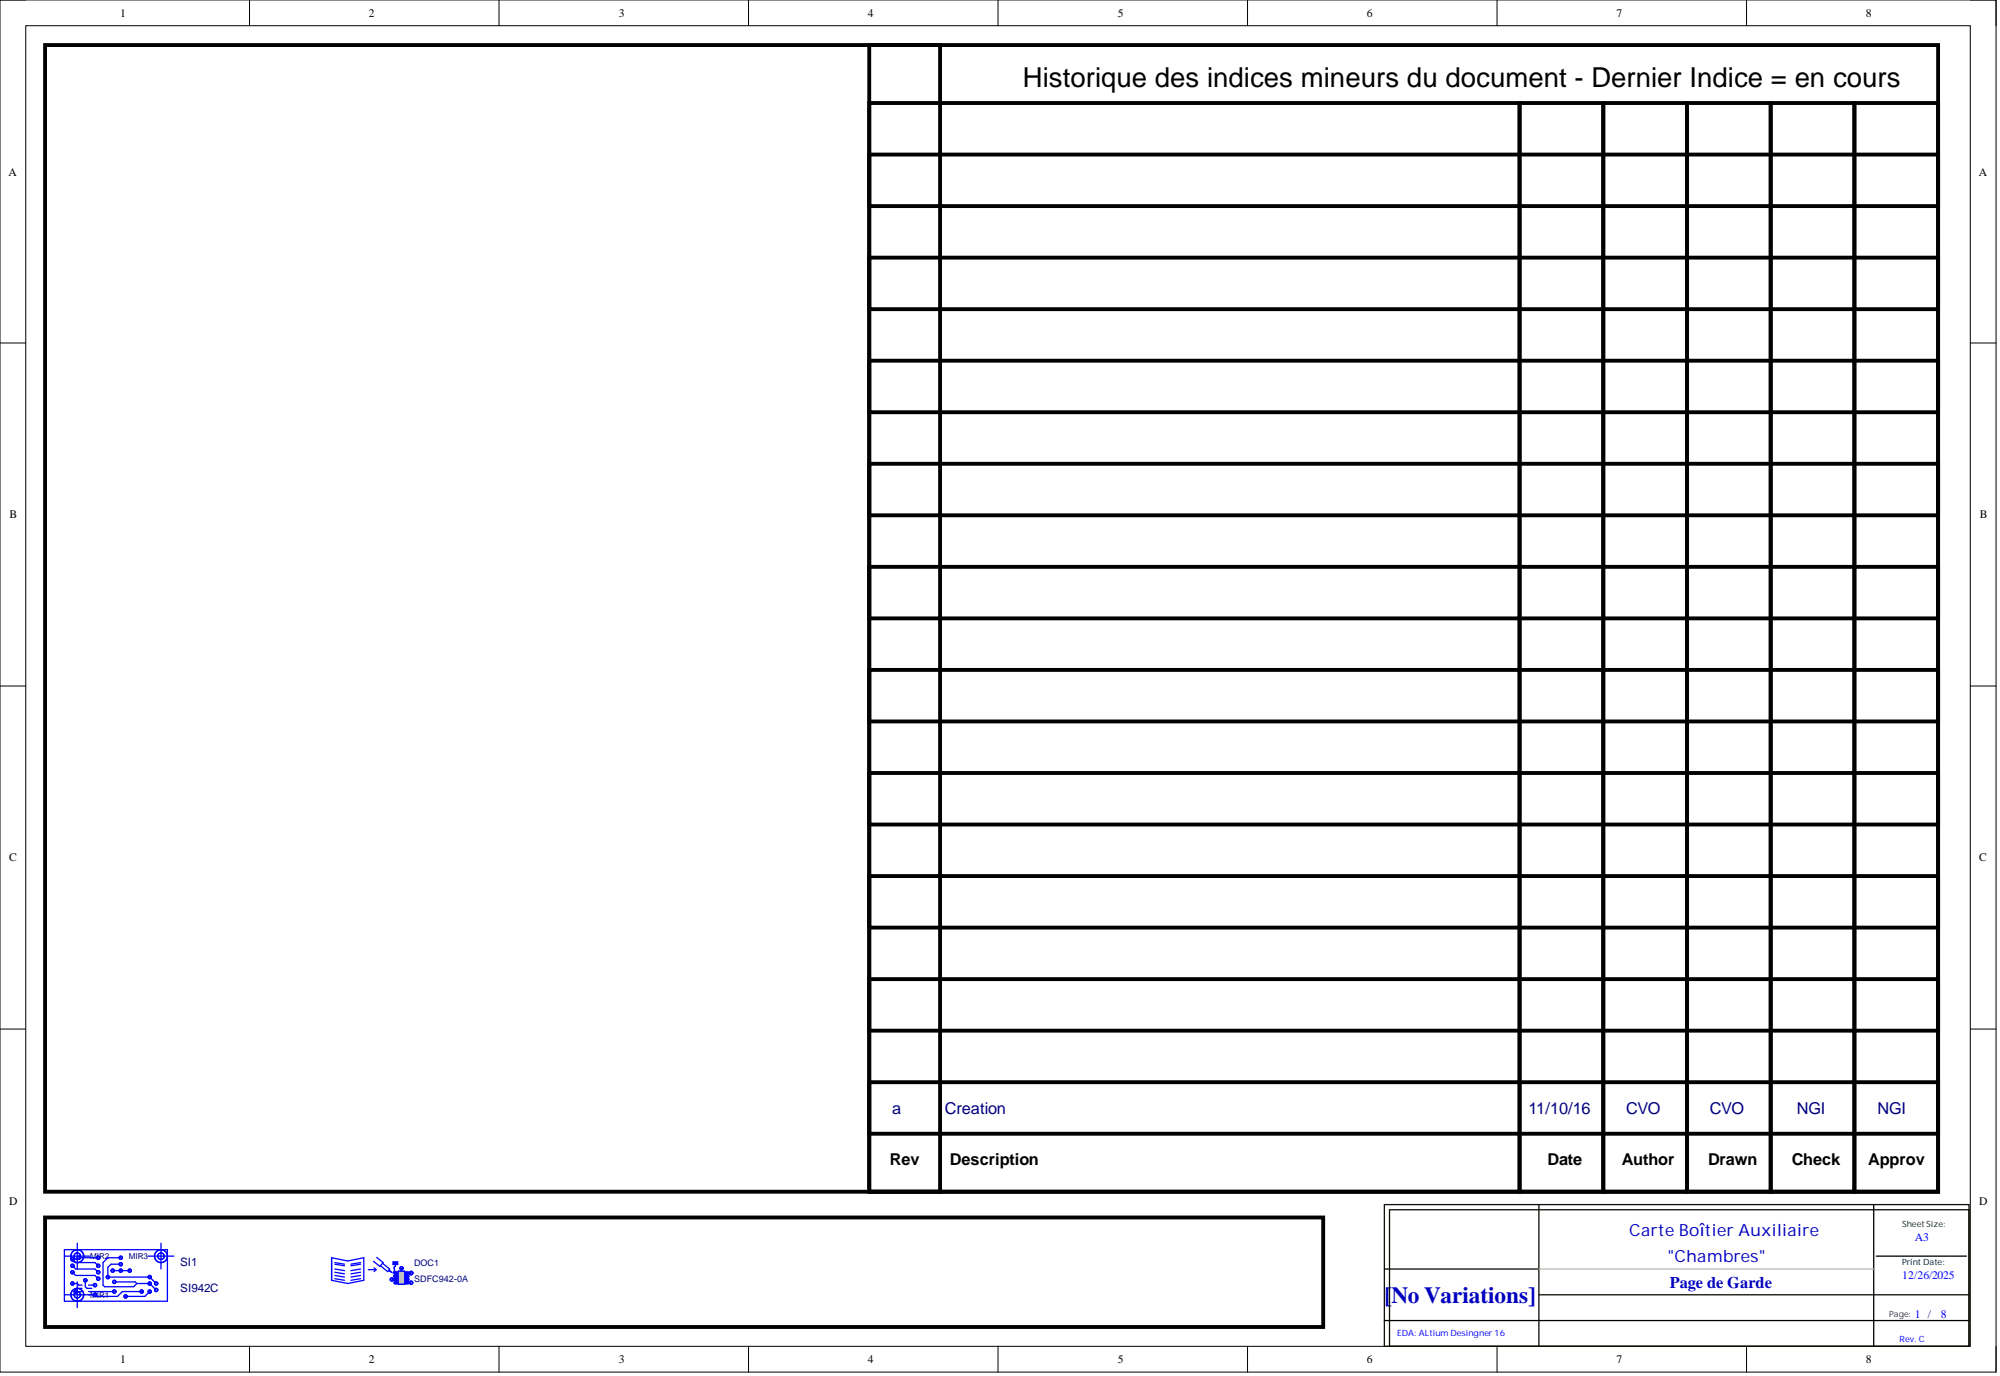
[picture p16: page 1]
t Date:; bres" CODOC1

Historique des indices mineurs du document - Dernier Indice = en cours

a | Creat i o n | 11/10/ 1 6 | C V O | C V O | N G I | N G I

Rev | Descripti o n | Dat e | Autho r | Draw n | Check | Approv

[No Variations] | Page de Garde

Pag e: /

EDA: ALti u m Desi n g ner | | Rev. C

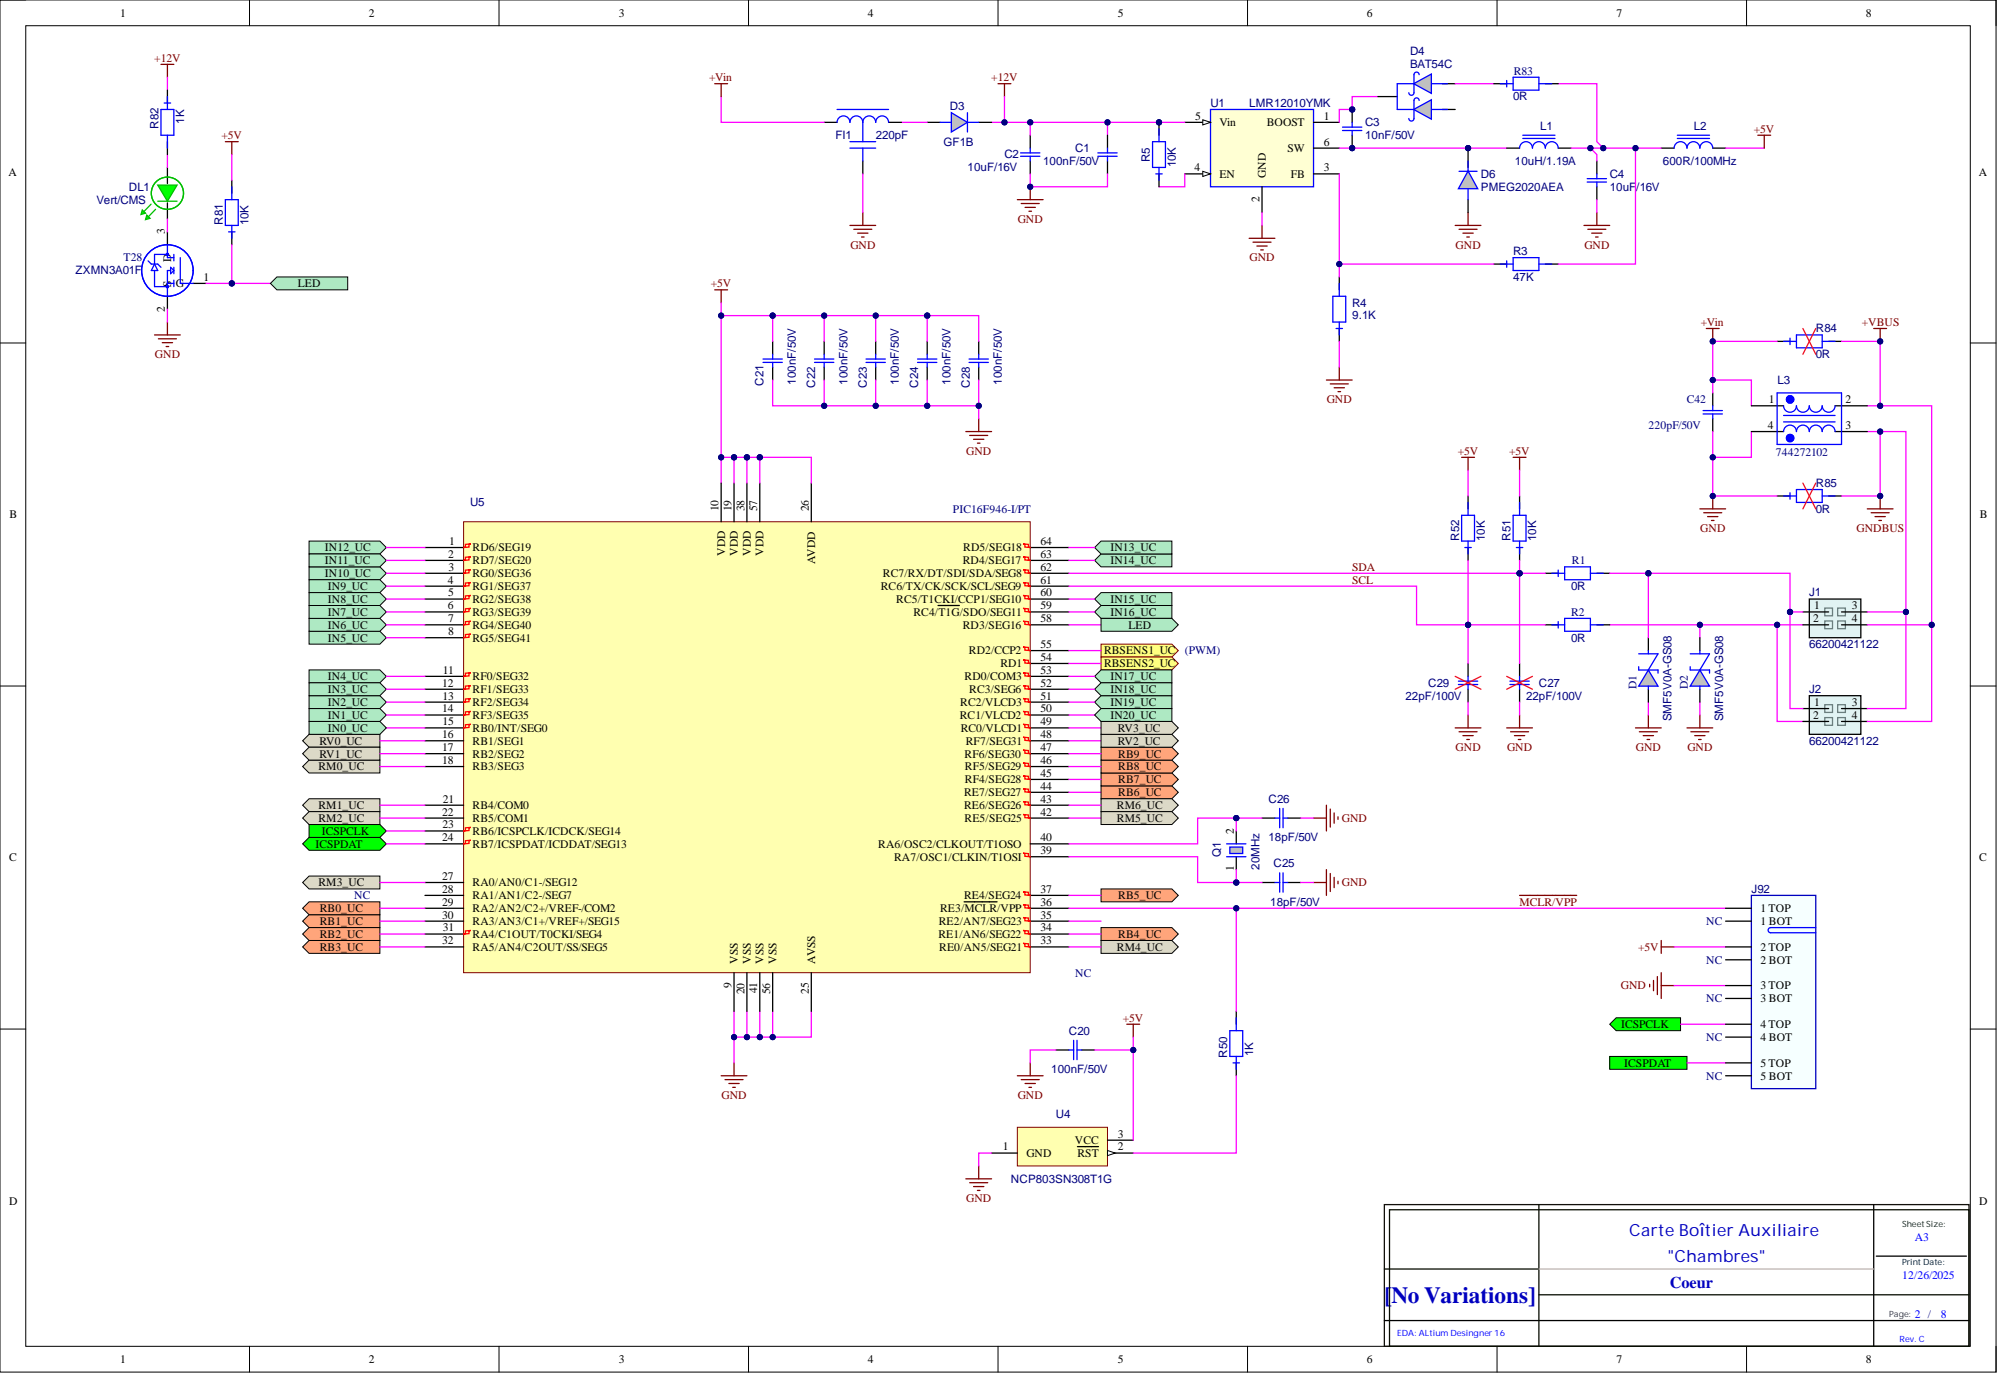
[picture p17: page 2]

SCL

Coeur

Pag e: /

EDA: ALti u m Desi n g ner | | Rev. C

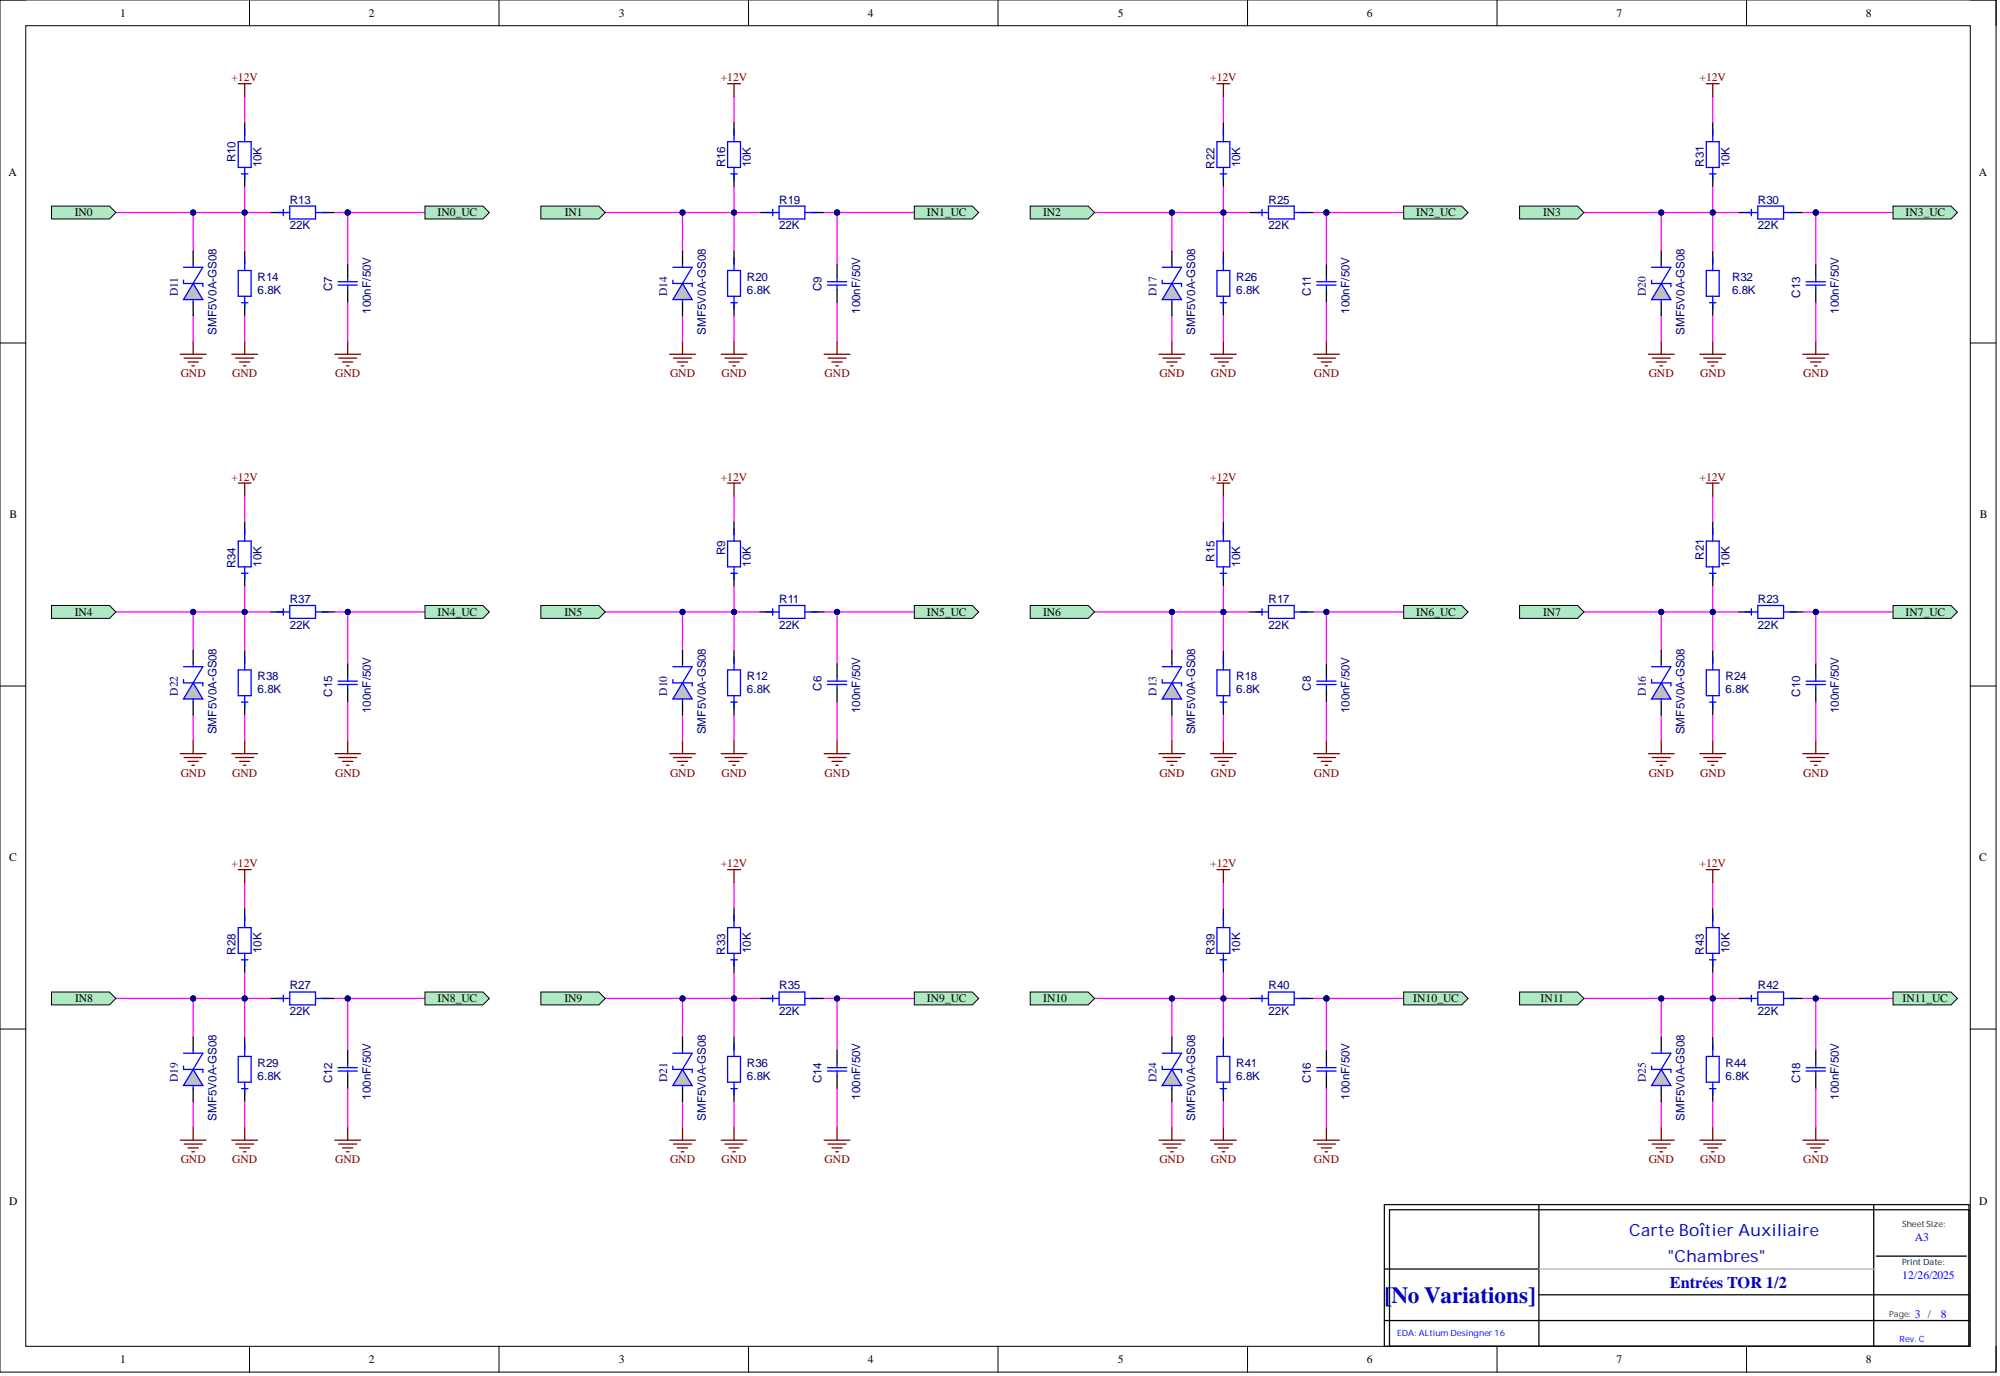
[picture p18: page 3]

Page:

EDA: ALtium Desingner 16 | | Rev. C

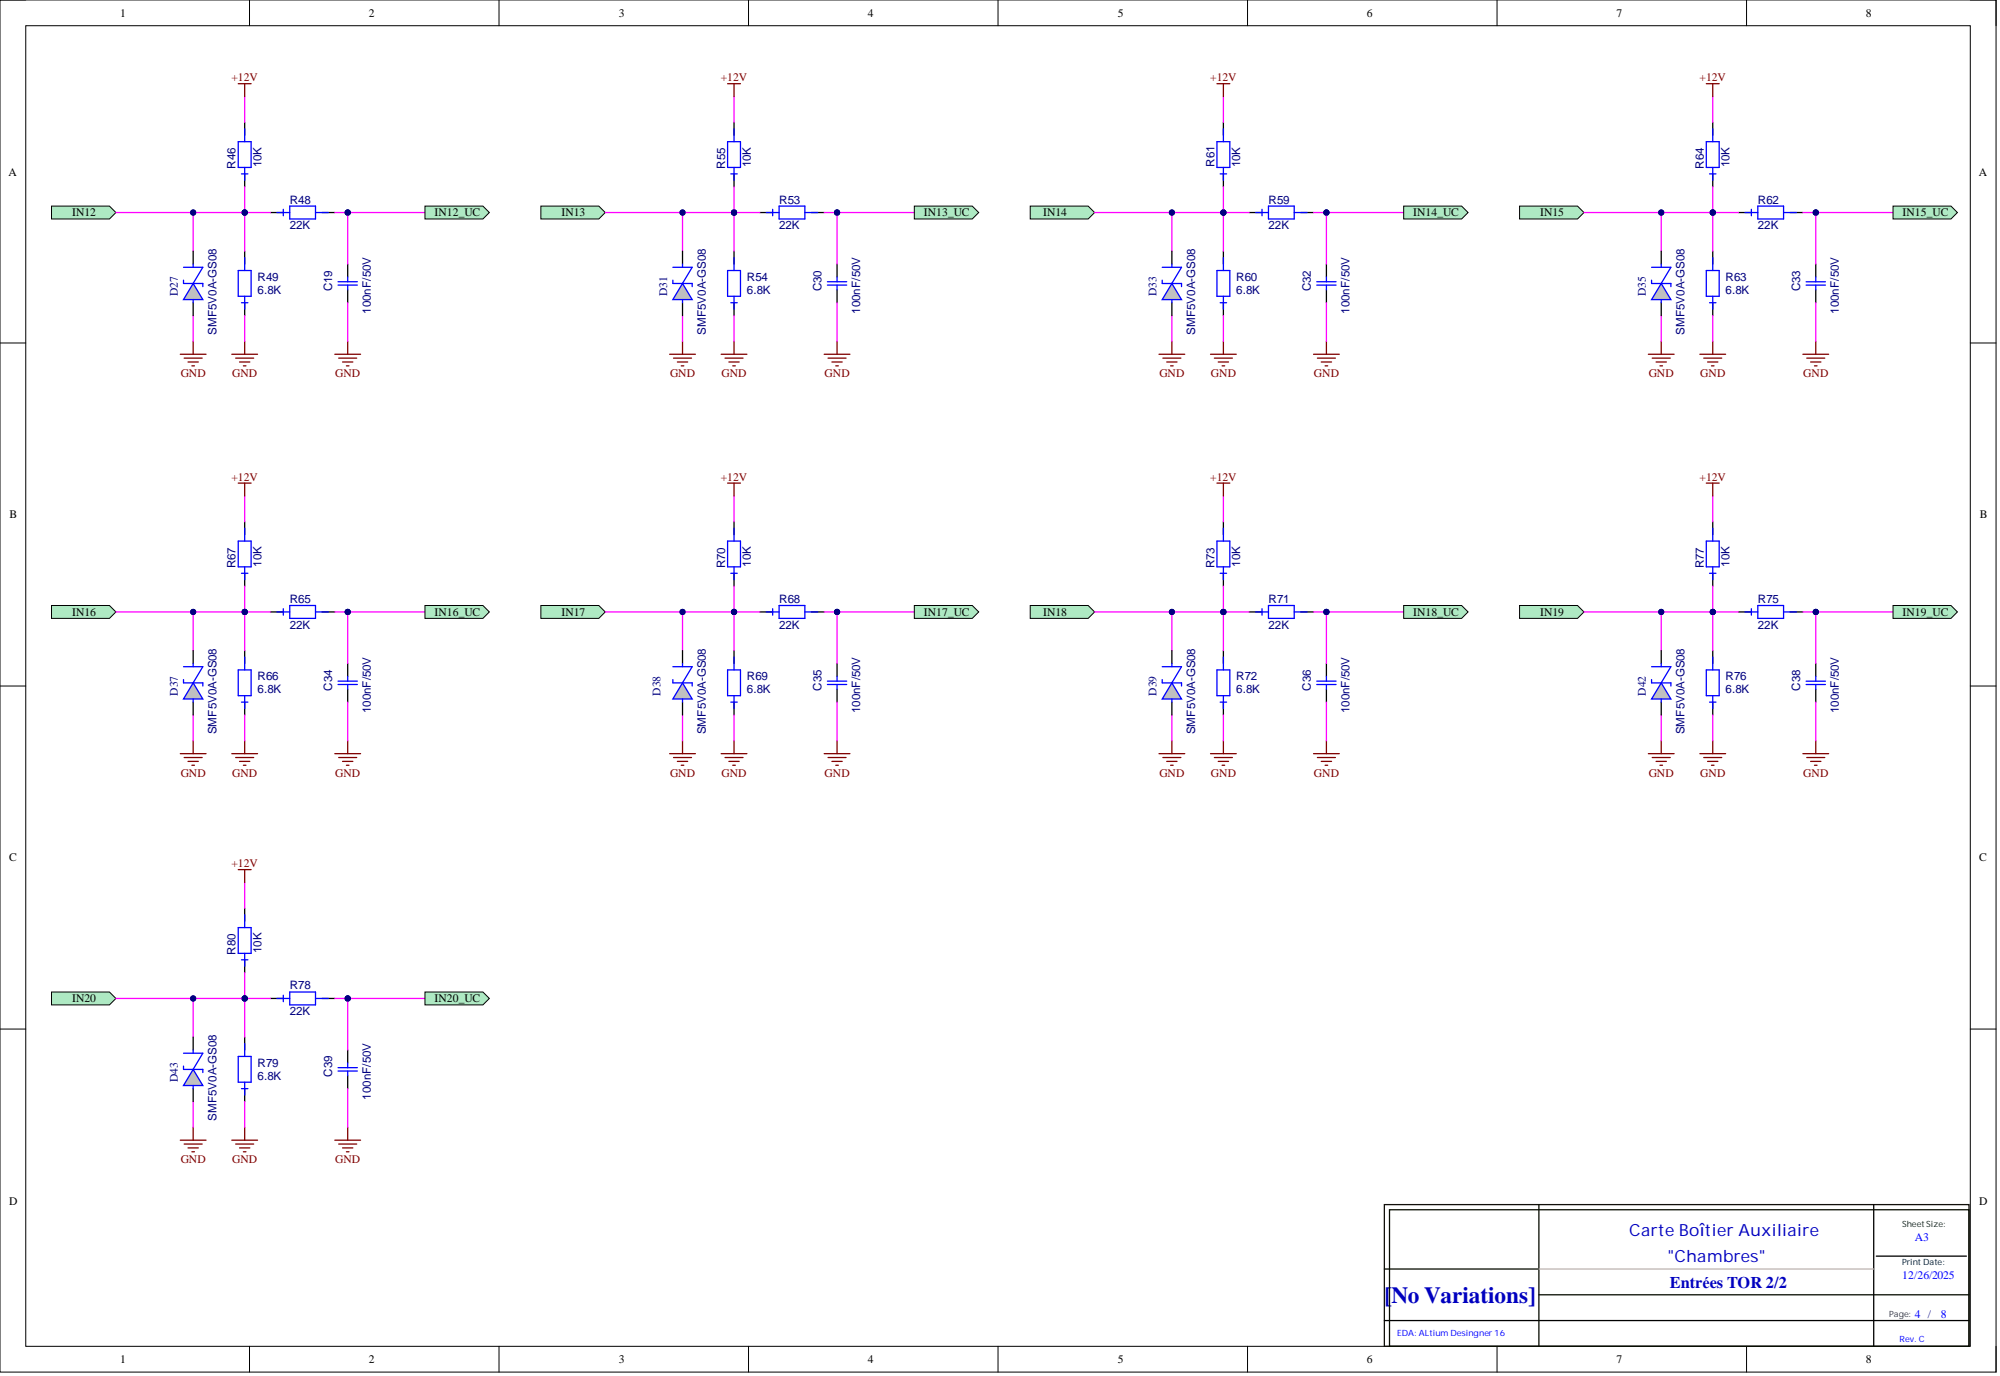
[picture p19: page 4]

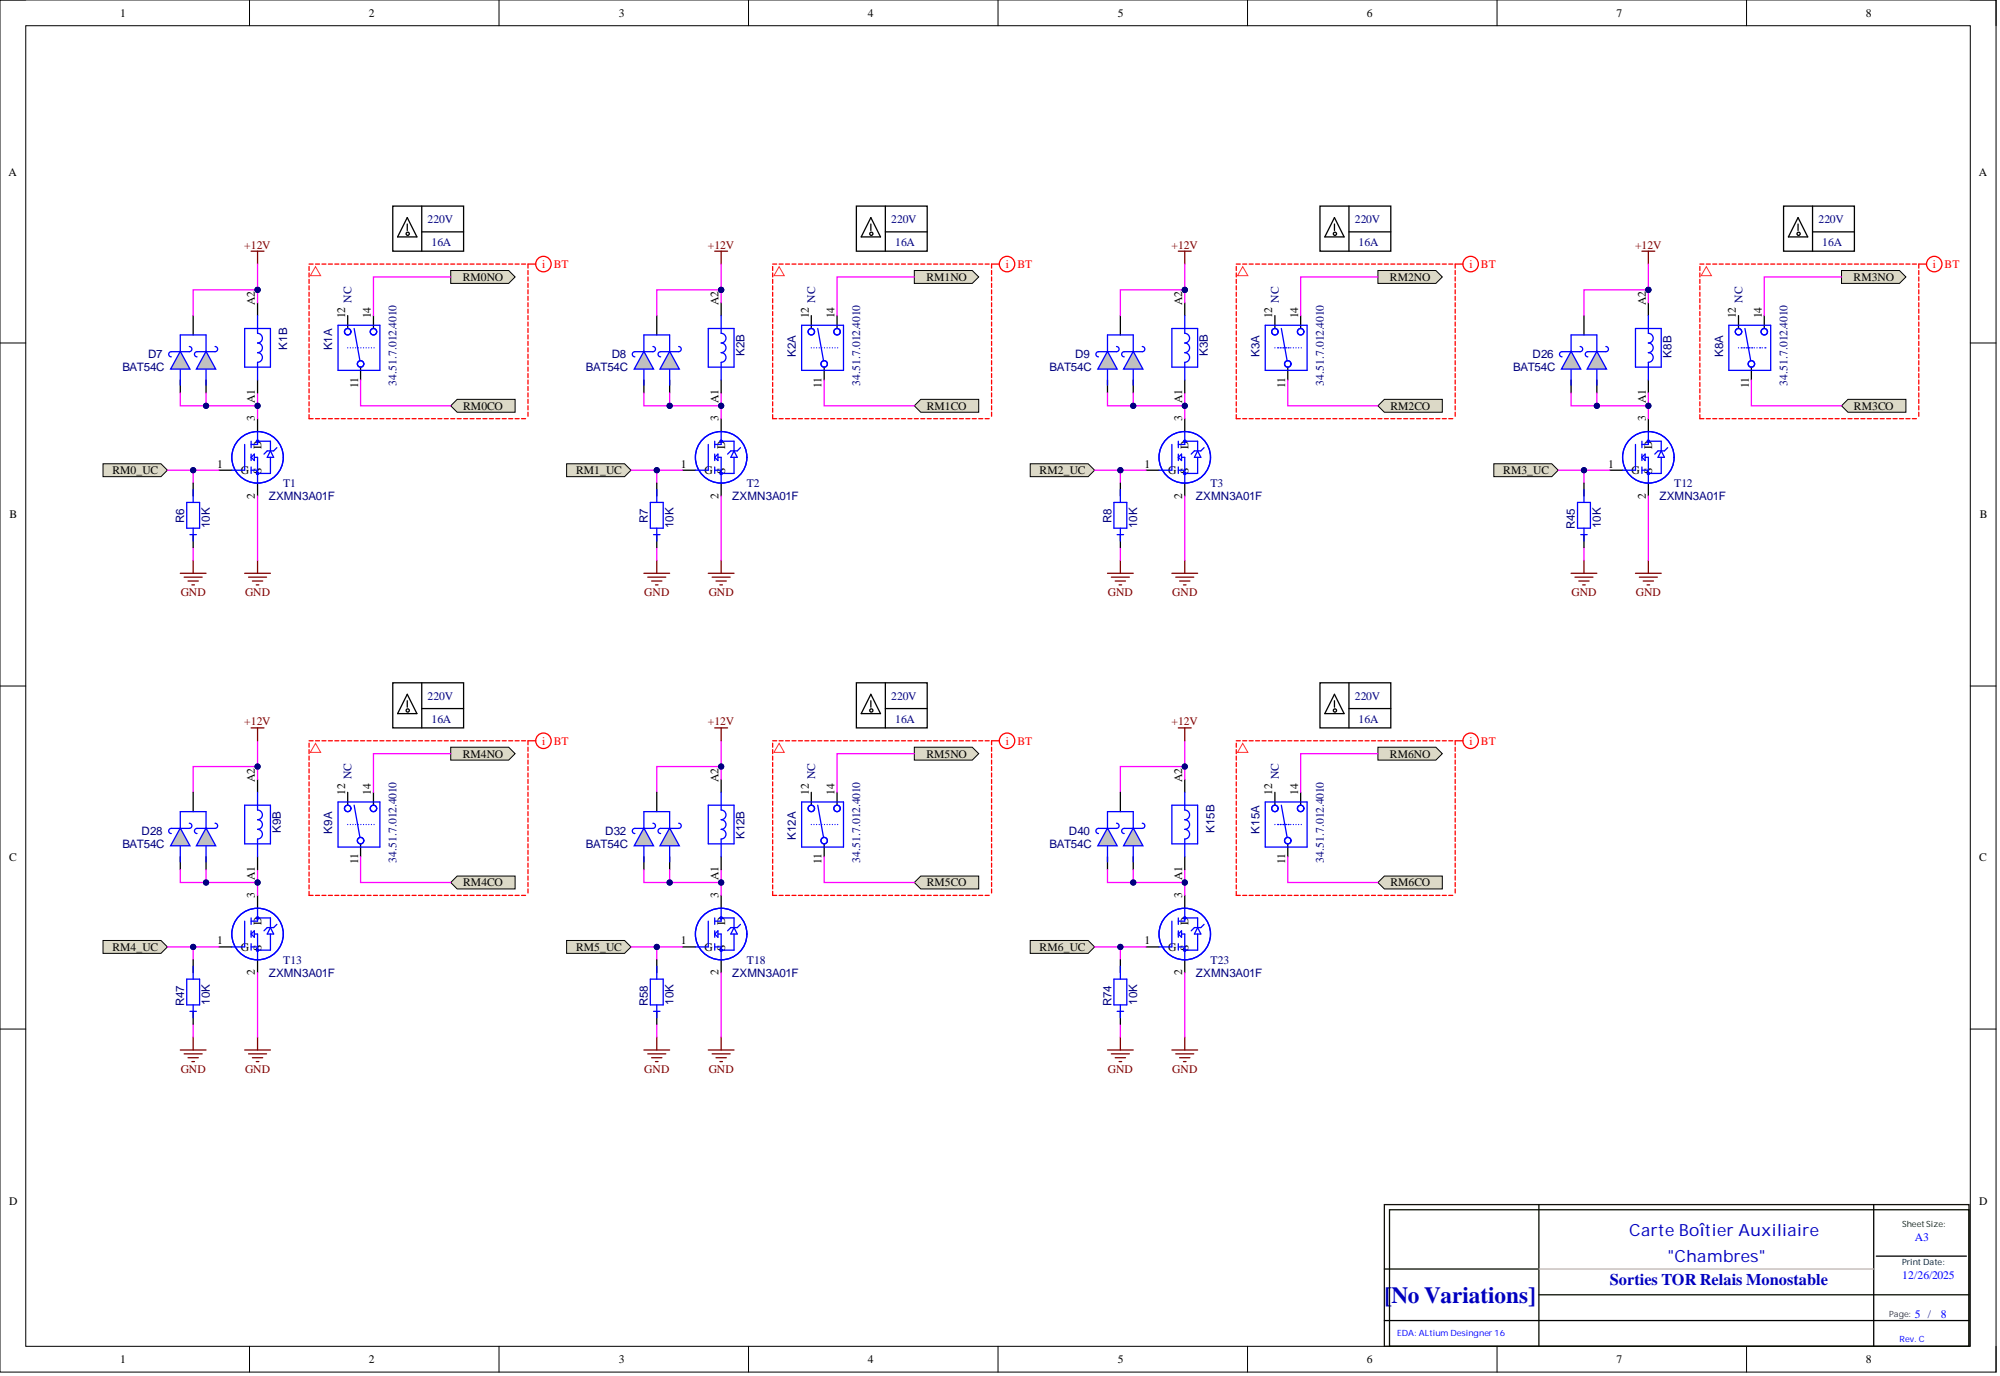
[picture p20: page 5]

Sorties TOR Relais Monostable

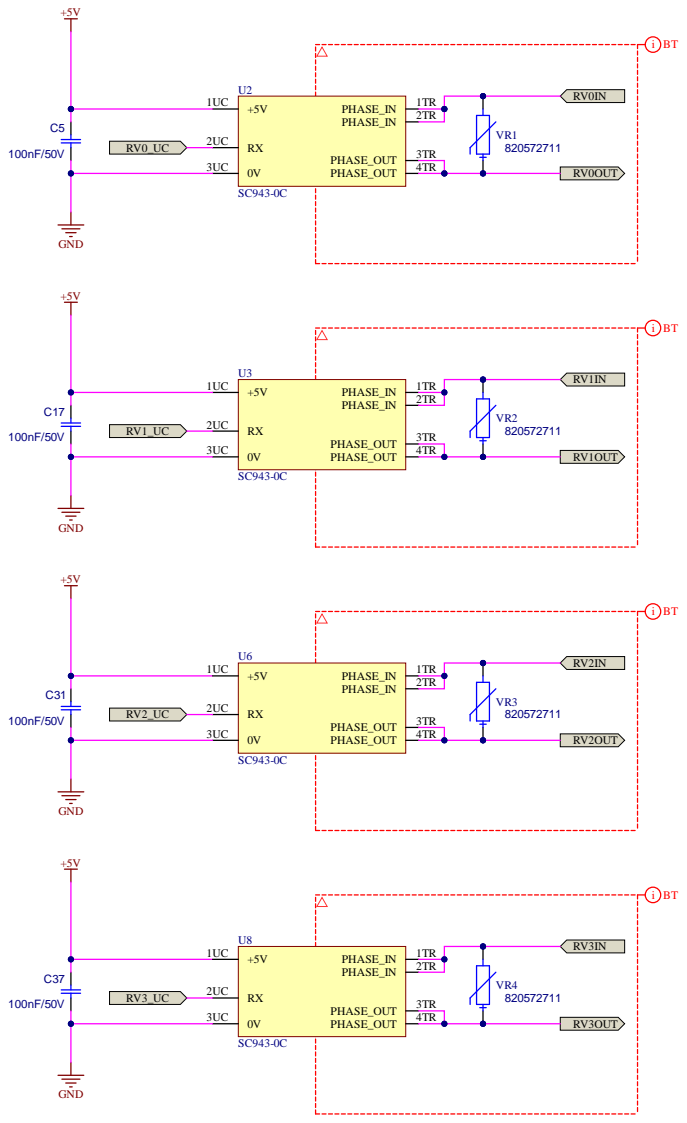
[picture p21: page 6]

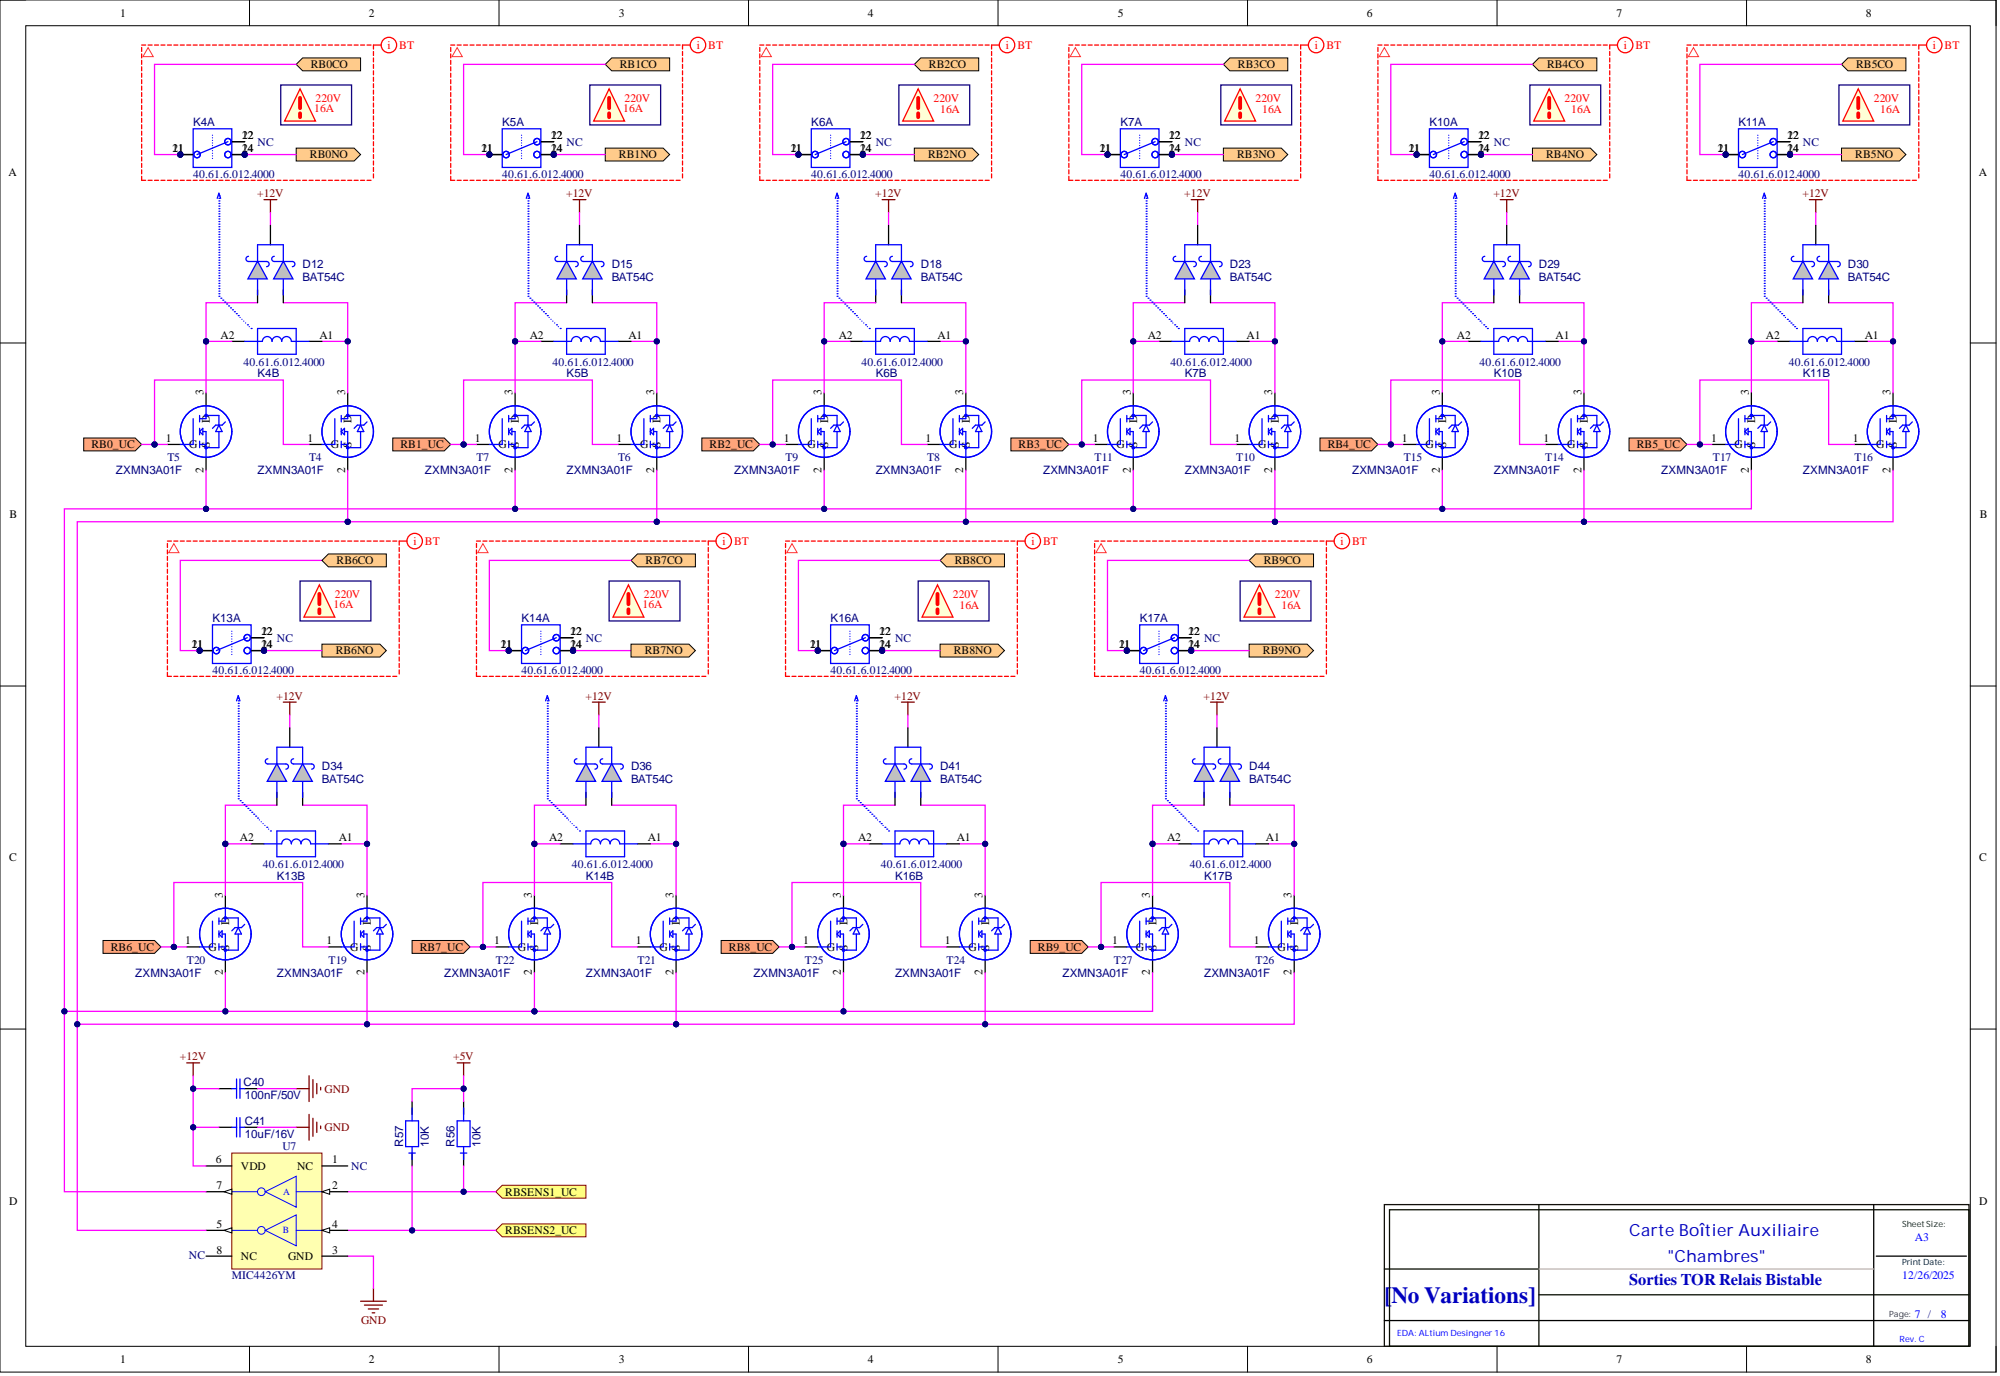
[picture p22: page 7]

"Chambres"
Sorties TOR Relais Bistable

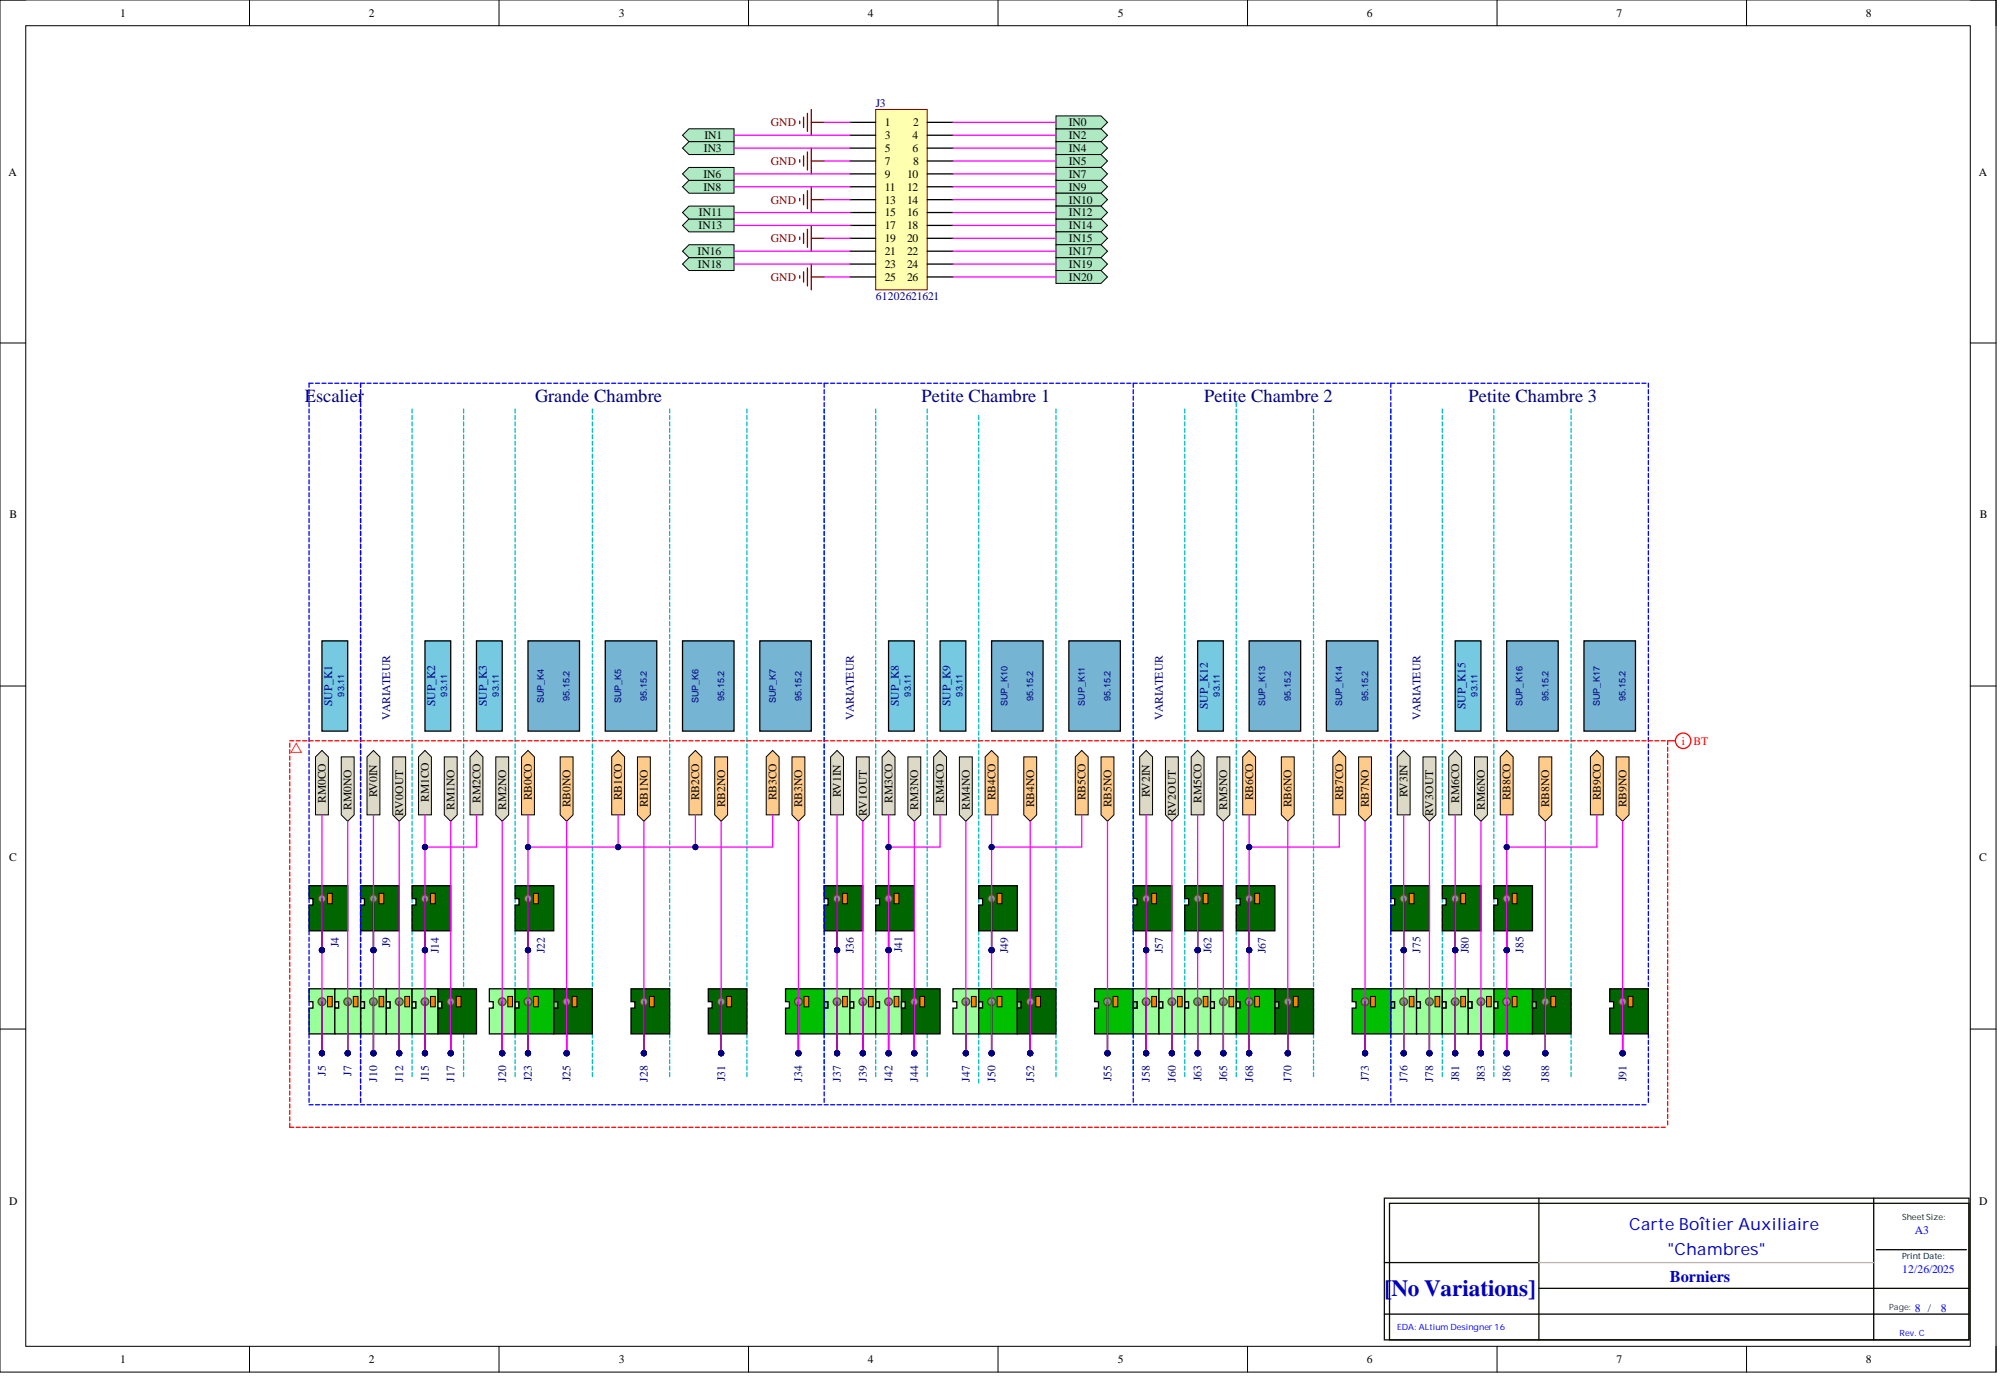
[picture p23: page 8]
