essensys-hub/essensys-board-SC942C/SC942C/Assembly/SC942C_Assembly.PDF

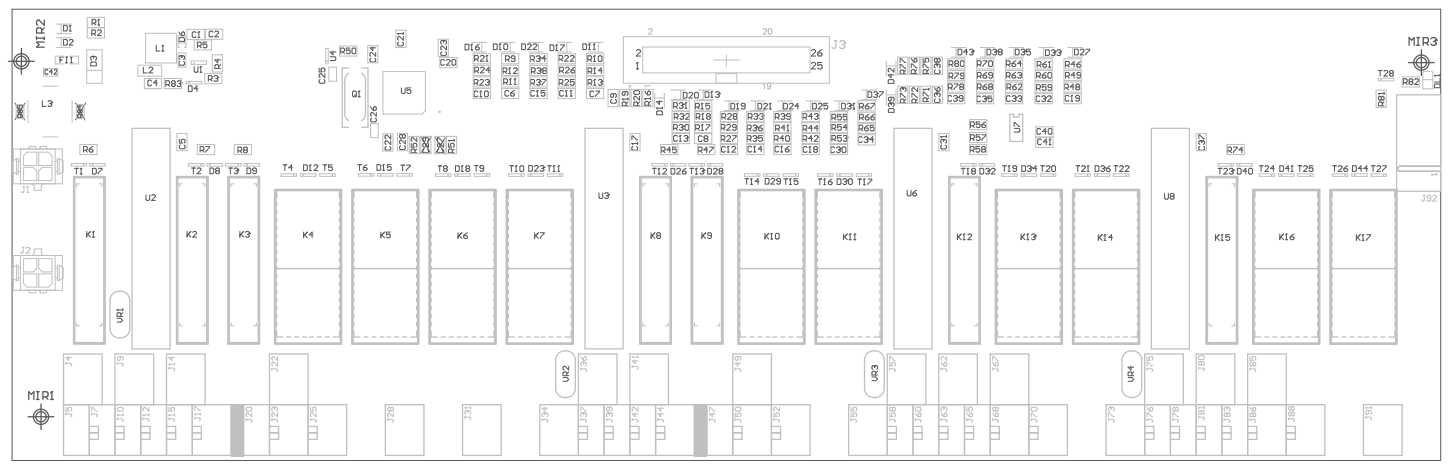
[picture p24: page 1]
