essensys-hub/essensys-board-SC942C/SC942C/Checks/SC942C_Mechanical.pdf

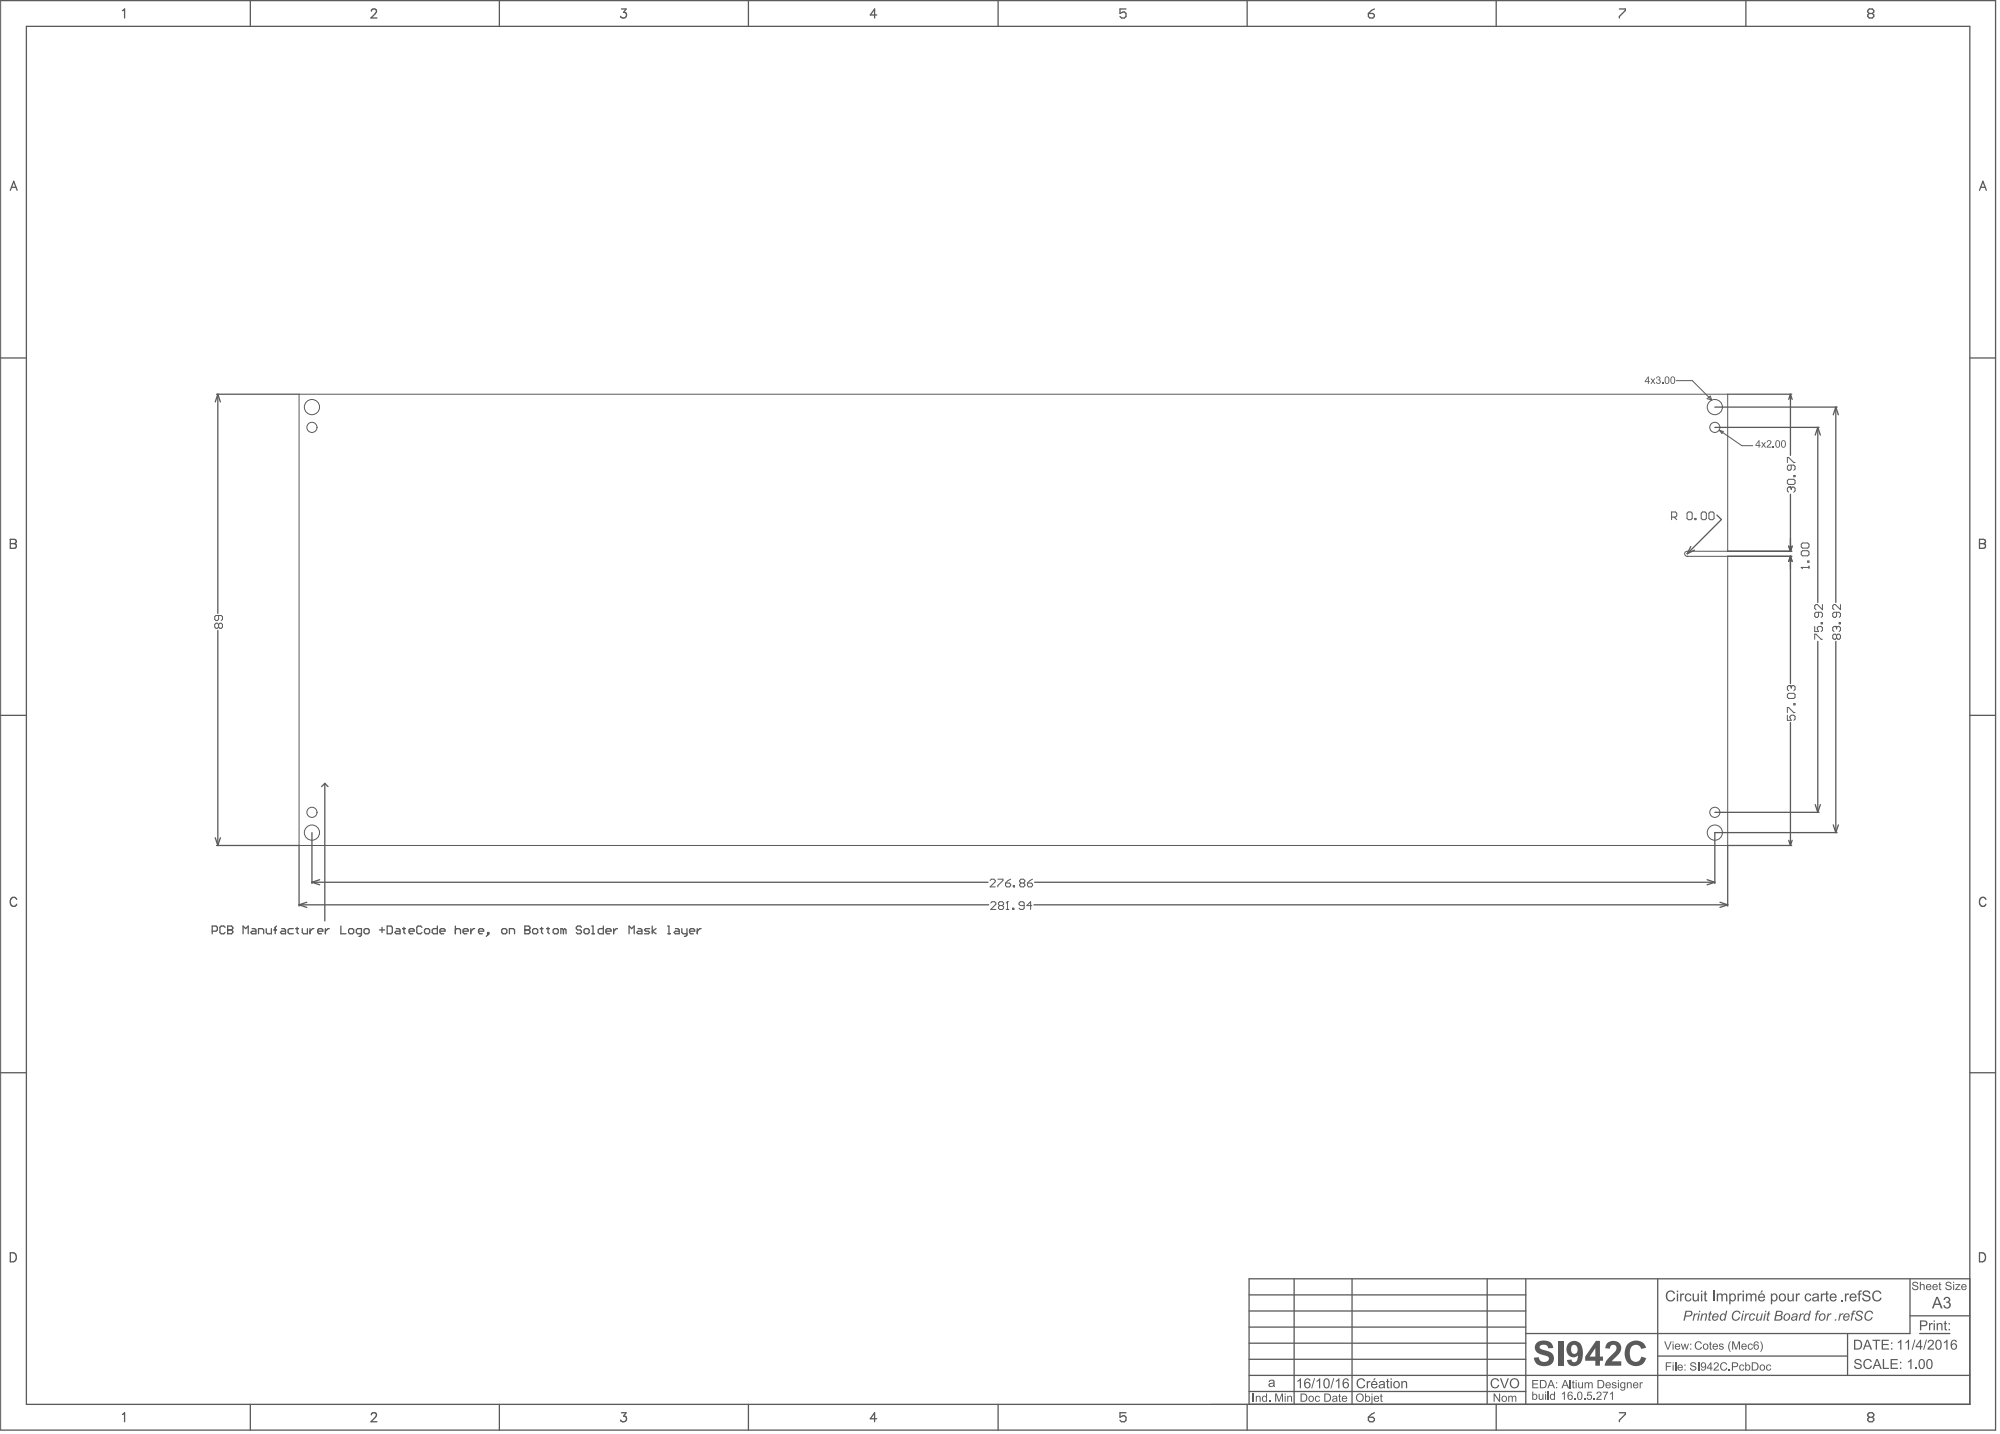
[picture p33: page 1]
