essensys-hub/essensys-board-SC942C/docs/assets/pdfs/SC942C_Assembly.pdf

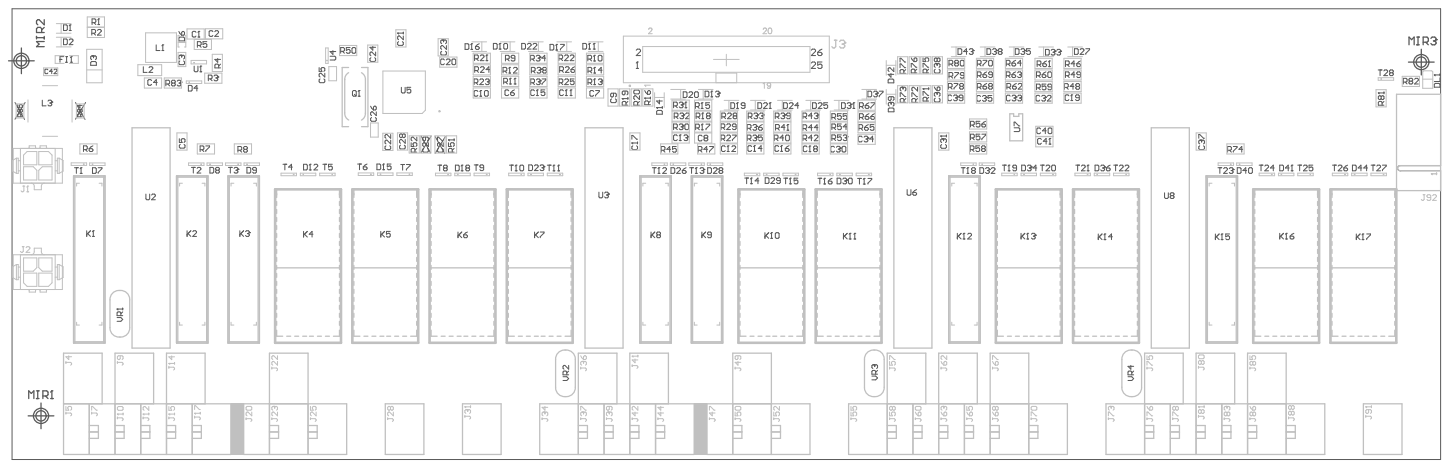
[picture p34: page 1]
