essensys-hub/essensys-board-SC942C/SC942C/Checks/SC942C_Drills.pdf

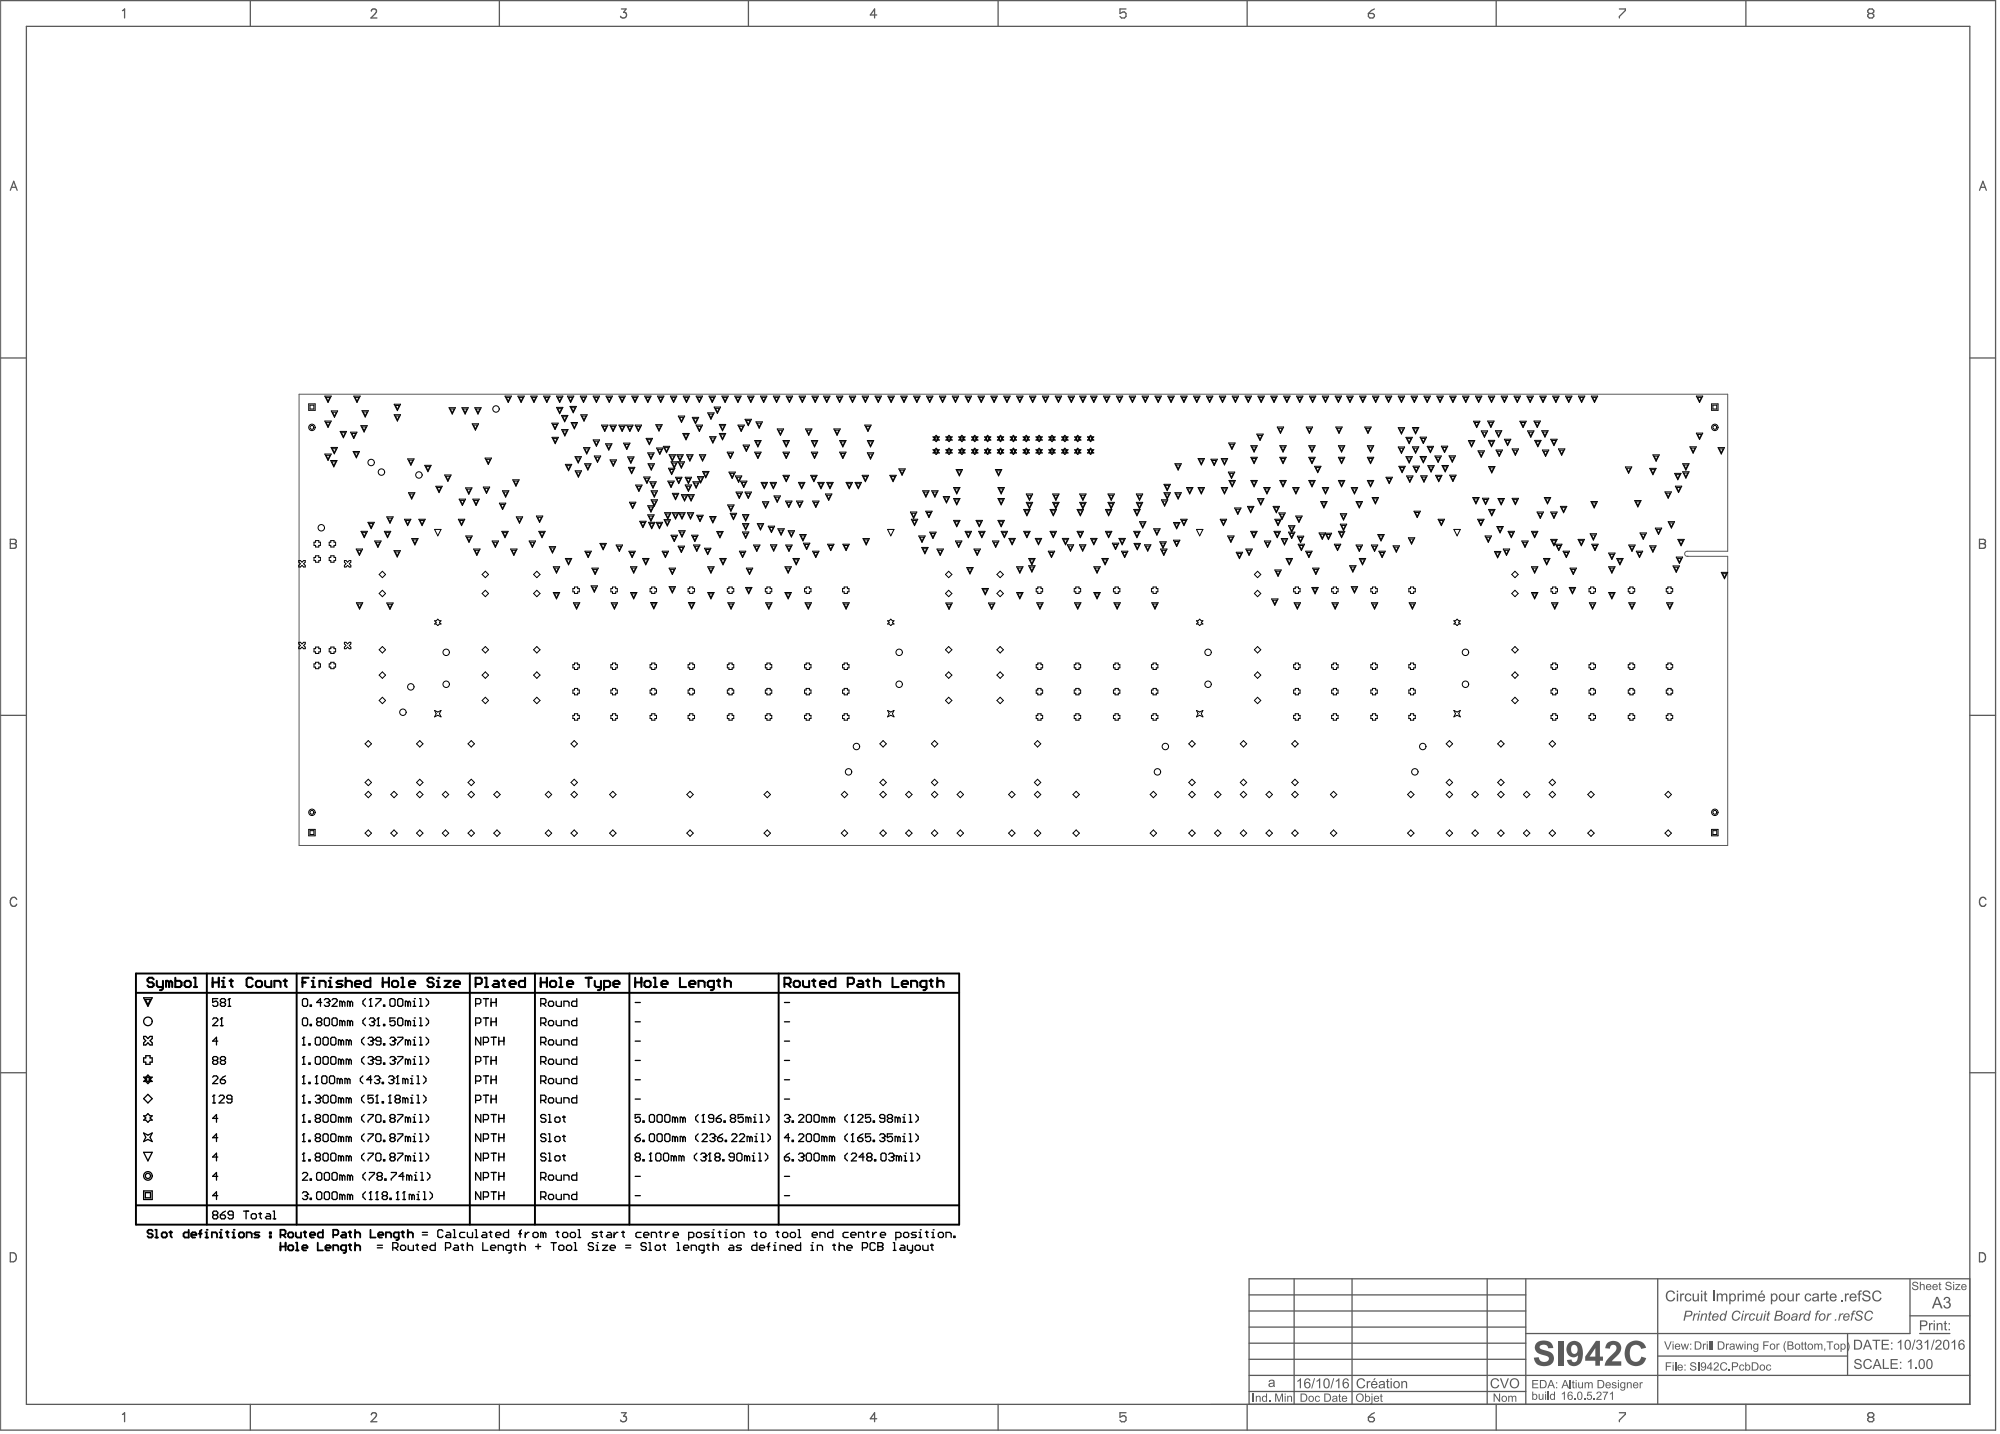
[picture p35: page 1]

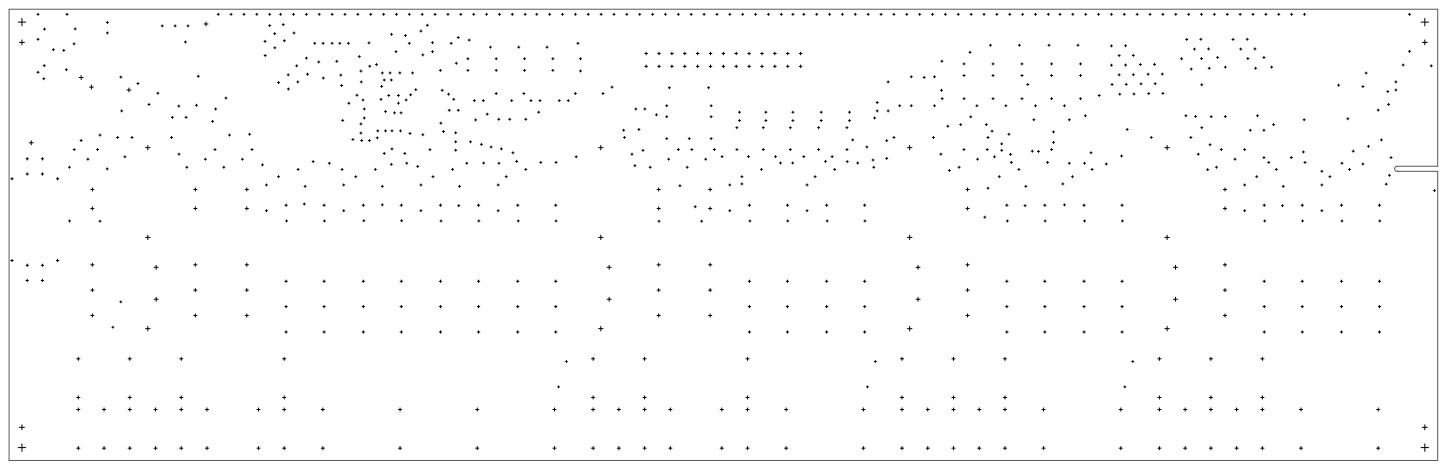
[picture p36: page 2]
