essensys-hub/essensys-board-SC942C/SC942C/Gerbers/Panel/SI942C panel drawing.pdf

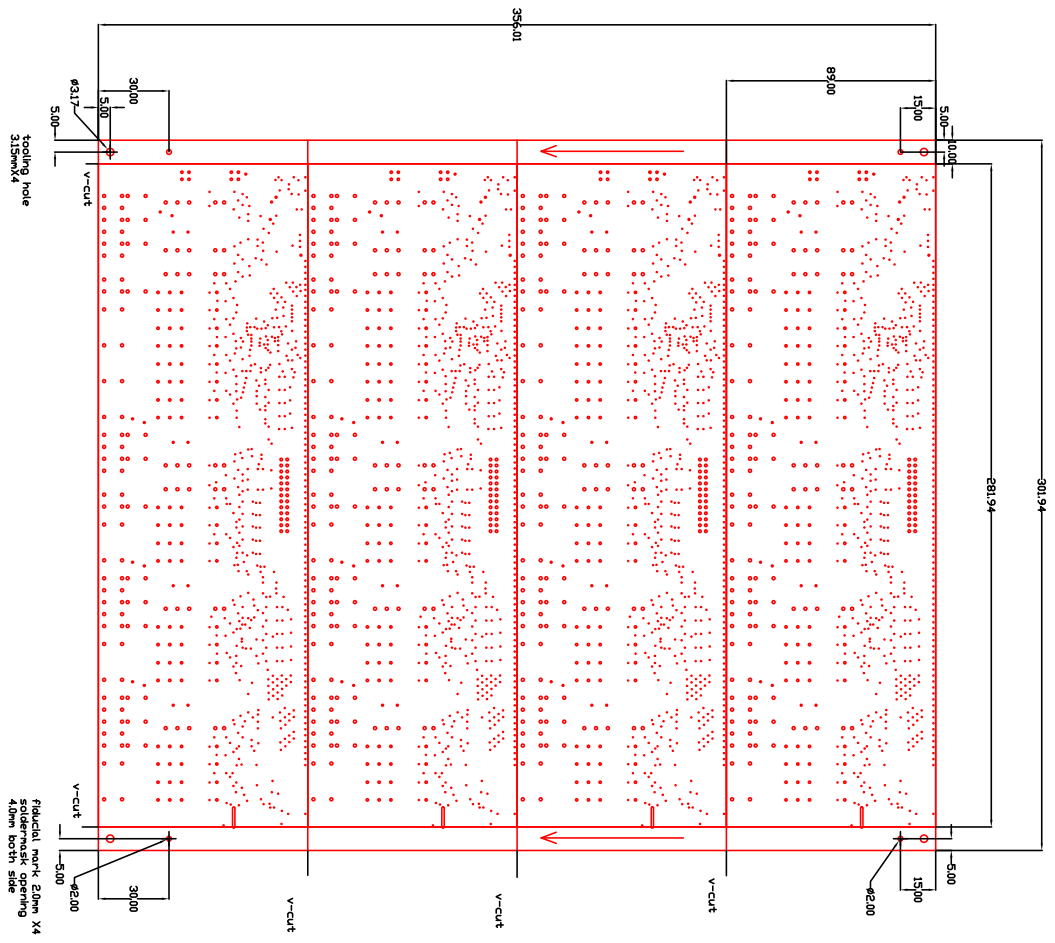
[picture p37: page 1]
