essensys-hub/essensys-board-SC942C/SC942C/Assembly/_Archives/SC942C_Schematic.pdf

a | Cr e atio n | 1 1/1 0/1 6 | CV O | CV O | NGI | NGI

Re v | De s cription | Da t e | Author | Drawn | Che c k | Approv

C a r t e B o î tie r Auxiliair e " Cha m b r es" | S h e e t Size : A 3

[No Variations] | P a ge de Garde

E D A : A L tium D esin g n e r 1 6 | | R e v . C

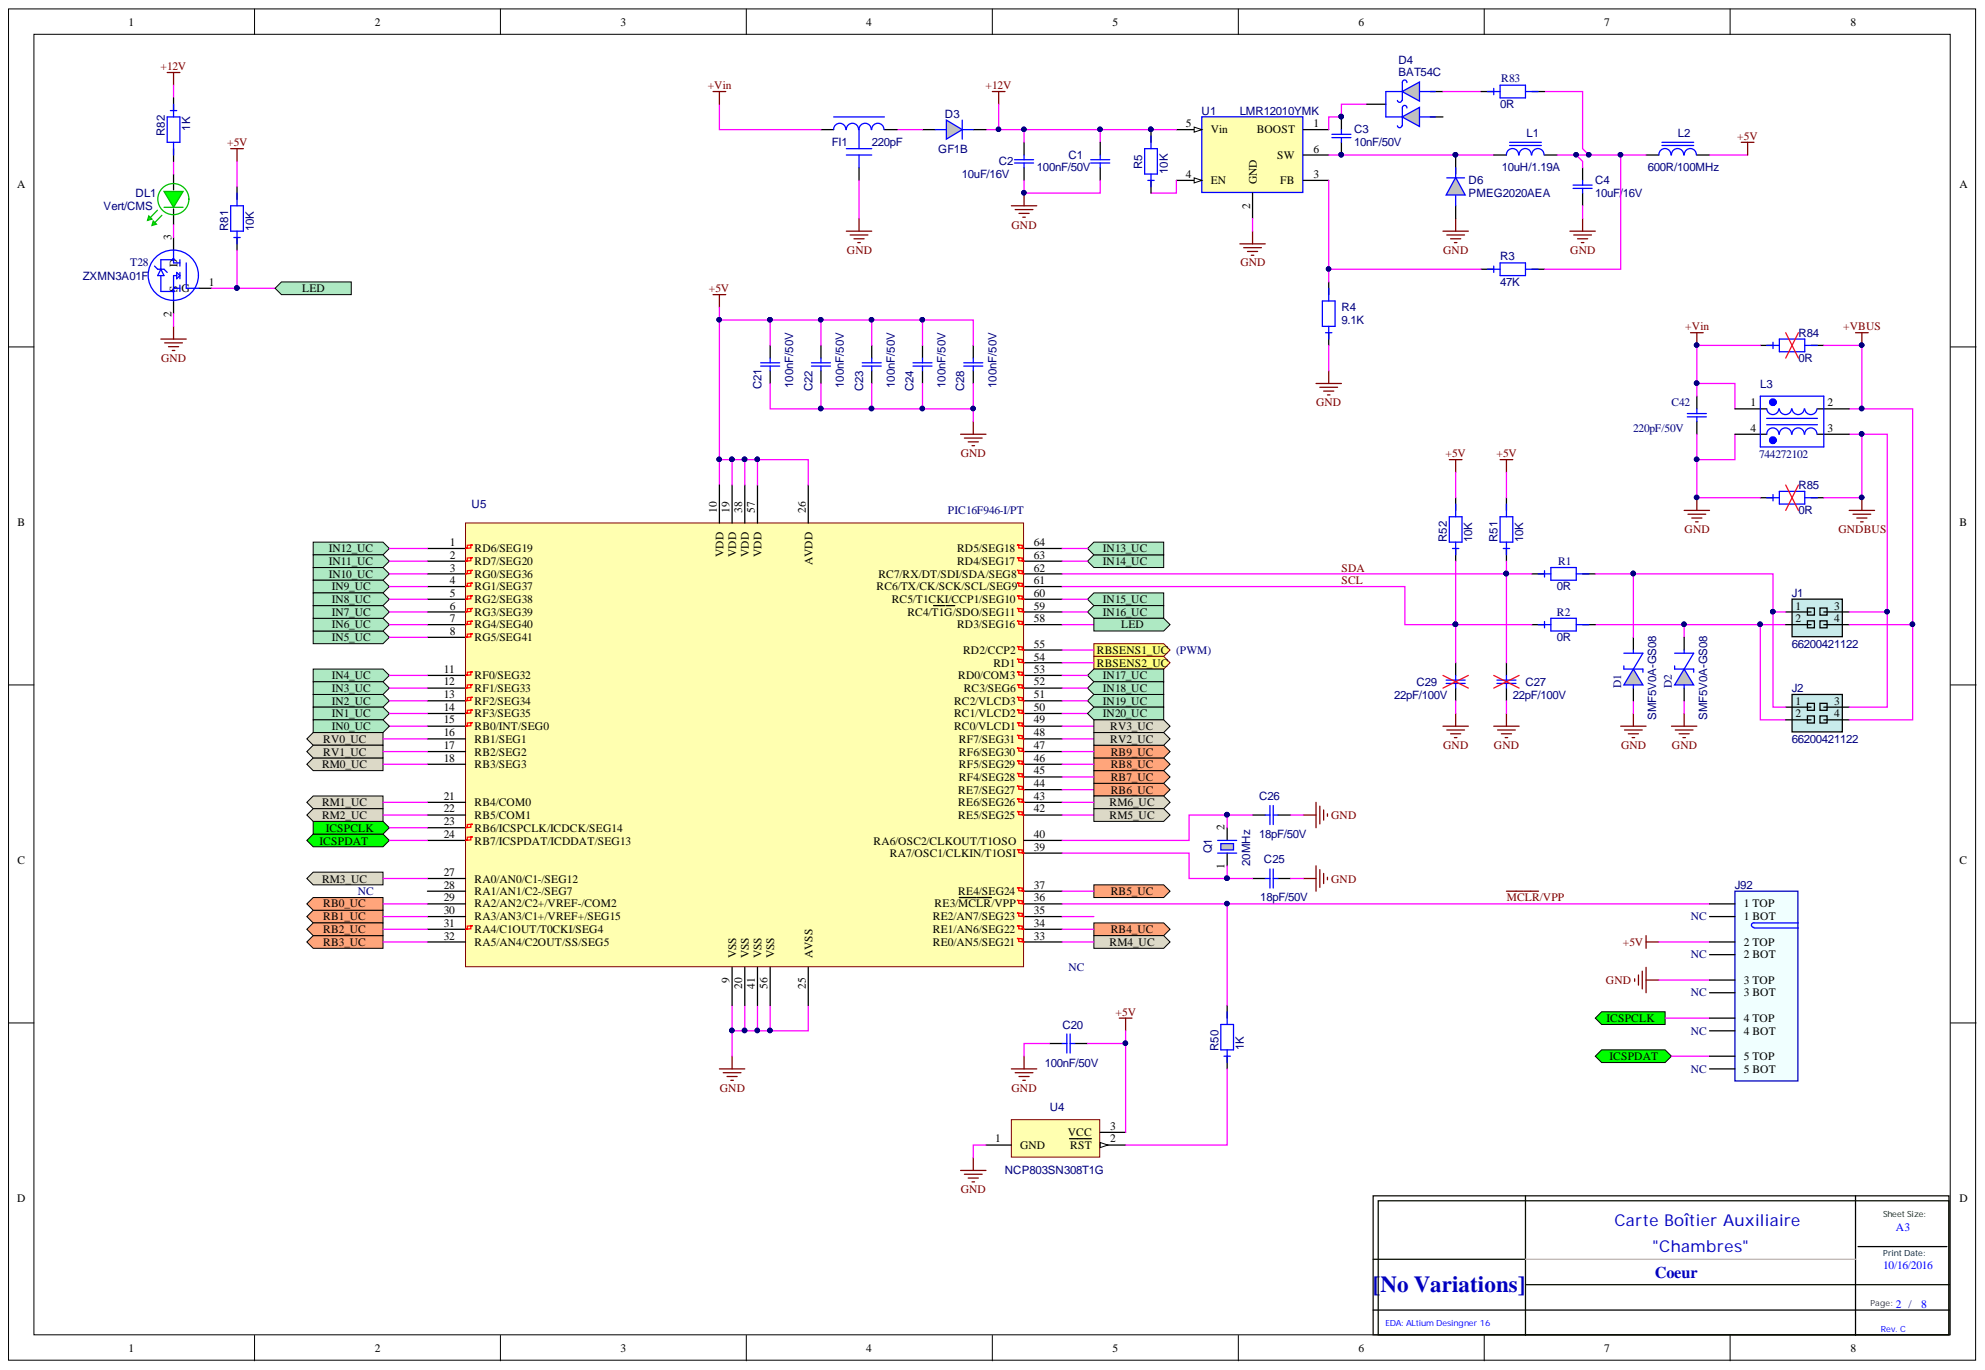
[picture p38: page 2]

L3 | 2

[No Variations] | Coeur

Page: 2 / 8

EDA: ALtium Desingner 16 | | Rev. C


[No Variations] | Entrées TOR 1/2

Page: 3 / 8

EDA: ALtium Desingner 16

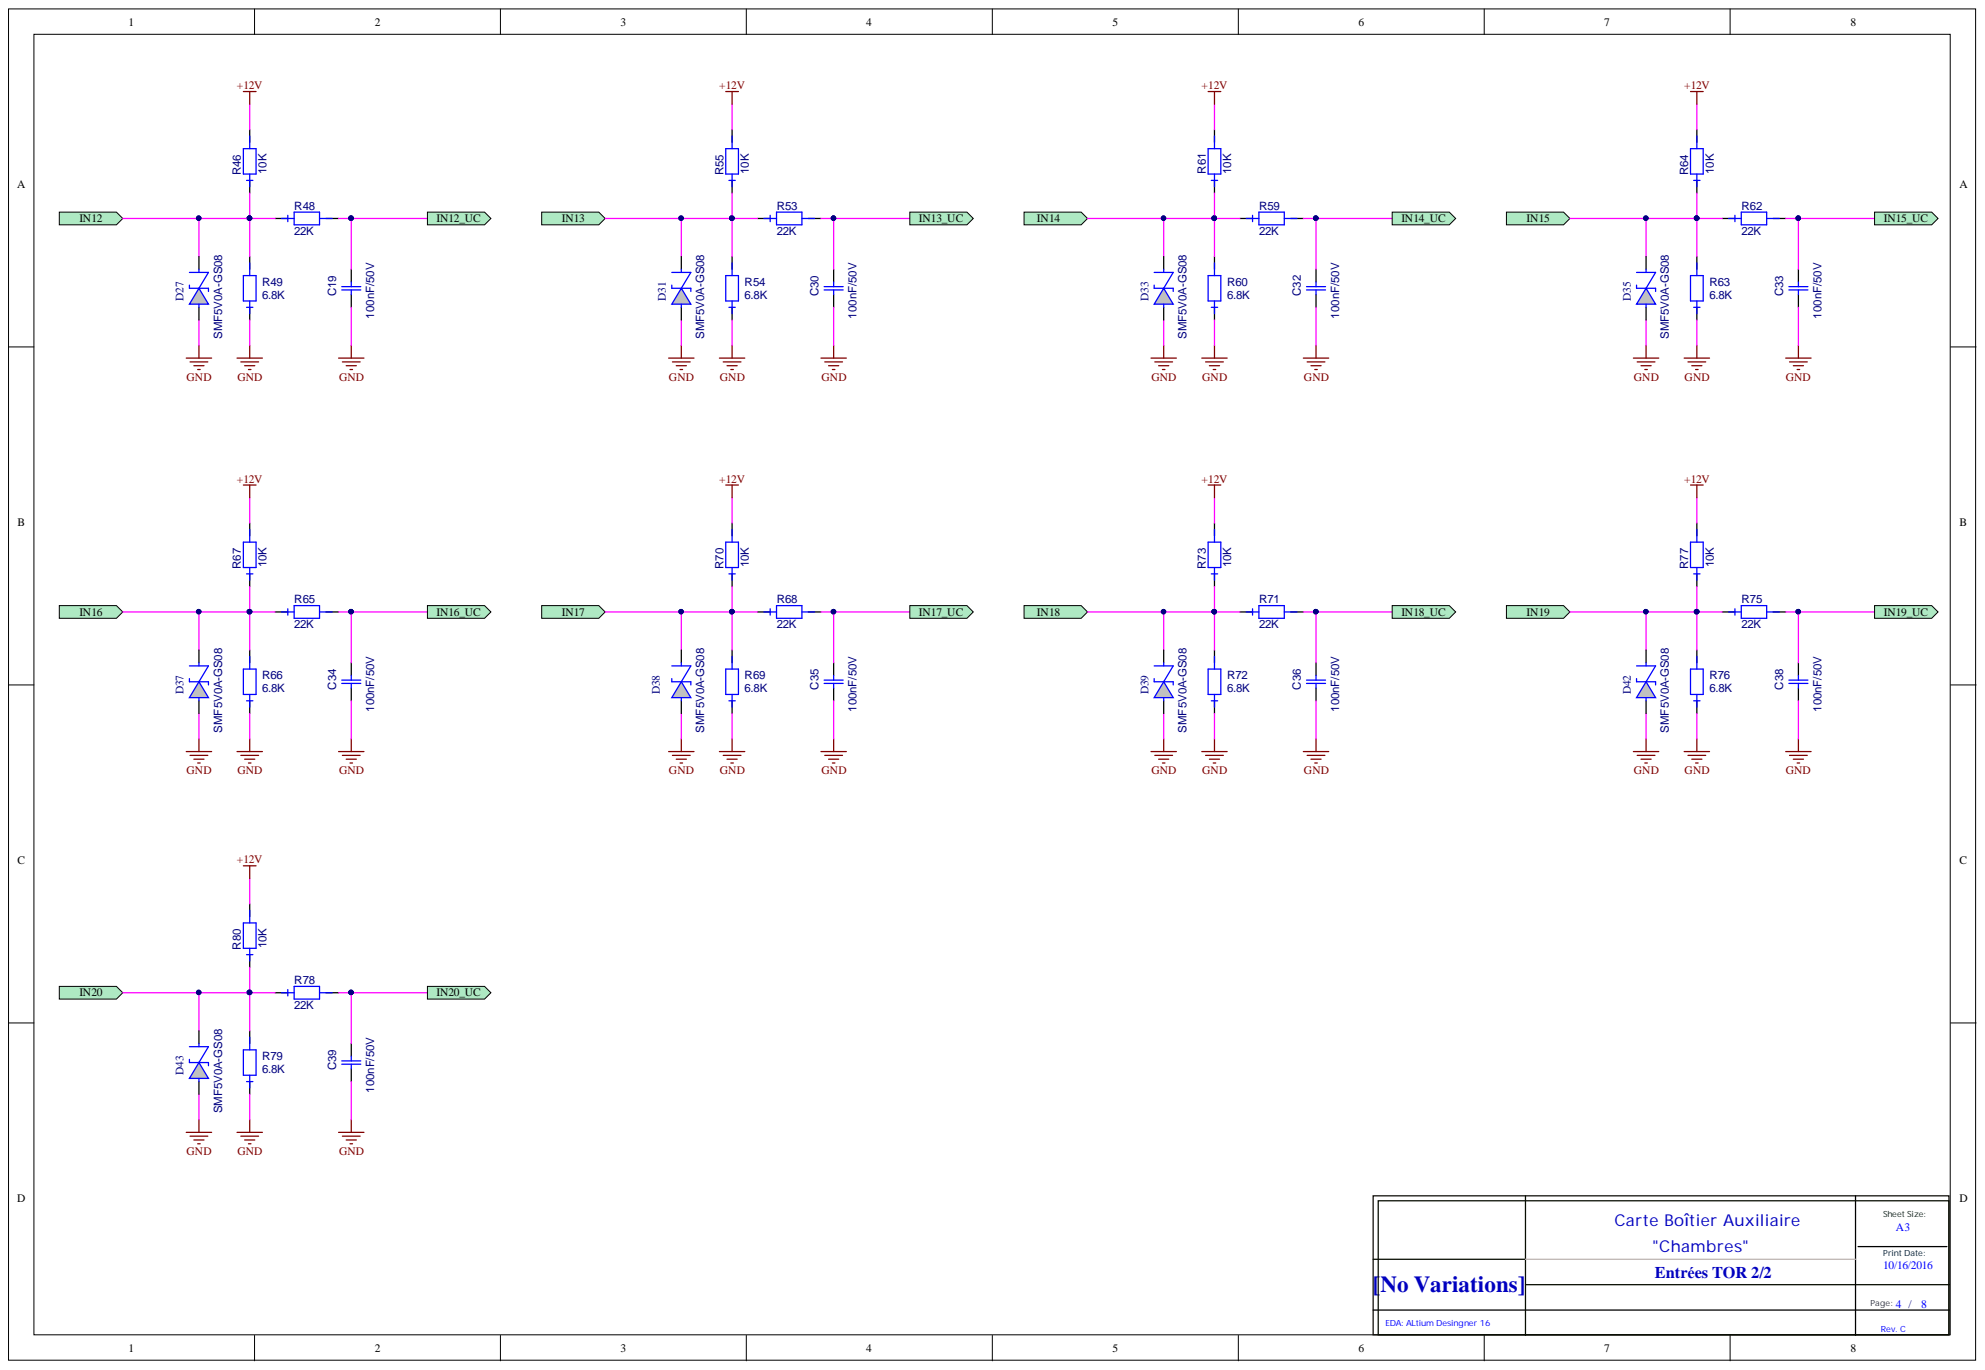
[picture p39: page 4]

[No Variations] | Entrées TOR 2/2

Page: 4 / 8

EDA: ALtium Desingner 16


[No Variations] | Sorties TOR Relais Monostable

Page: 5 / 8

EDA: ALtium Desingner 16


+5V 1UC | PHASE_OUT

Page: 6 / 8

EDA: ALtium Desingner 16 | | Rev. C


[No Variations] | Sorties TOR Relais Bistable

Page: 7 / 8

EDA: ALtium Desingner 16


Page: 8 / 8

EDA: ALtium Desingner 16 | | Rev. C
