essensys-hub/essensys-board-SC942C/(list of files, drawings)

Other design files:
SC942C/SC942C-0B_Borniers.SchDoc
SC942C/SC942C.PrjPcb
SC942C/SC942C_Coeur.SchDoc
SC942C/SC942C_ETOR1.SchDoc
SC942C/SC942C_ETOR2.SchDoc
SC942C/SC942C_Sommaire.SchDoc
SC942C/SC942C_STORRB.SchDoc
SC942C/SC942C_STORRM.SchDoc
SC942C/SC942C_Variateurs.SchDoc
SC942C/SDEC942-0B.SCHLIB
SC942C/SI942C.PcbLib
