essensys-hub/essensys-board-SC942C/SC942C/Prog/code_ba (fichiers sources 1.7)/source/variateur.h

extern unsigned short us_CodeVariateur (char);
//extern void vd_RampeVariateurs(void);
//extern void vd_CalculRampeVariateur(struct struct_Variateur * , unsigned char);
//extern void vd_ConfirmeVariateurs(void);
