essensys-hub/essensys-board-SC942C/(commit log)

2025-12-26 feat: Initial documentation for SC942C
    [1151710376.sldasm, 1151710512.sldasm, 1151724792.sldasm, 1151724928.sldasm, 1151725064.sldasm, 1790348.sldasm, 1790377.sldasm, 1790487.sldasm]
2025-12-26 docs: Update architecture with I2C protocol details
2026-10-11 docs(SC942C): variante de BOM et note de schéma « retouche foudre »
    Ajoute BOM_retouche-foudre.csv (BOM d'origine inchangée) et
    docs/retouche-foudre.md : 47 Ω anti-impulsion en série sur SDA/SCL,
    PTC 30 V à la place de l'entrée +VBUS, TVS 16 V en aval, C2 35 V,
    D6 40 V, option BAT54S, exception de marge assumée sur U1 (LMR12010).
    Refs essensys-hub/essensys-board-SC944D#1
    Feature: i2c-surge-protection-2026-10-007
2026-10-12 feat(SC942C): firmware BA 1.8 (chien de garde, erreurs SSP, comm_stat)
    Sources 1.8 dans « code_ba (fichiers sources 1.8) », la 1.7 restant
    intacte pour le retour arrière (tâche 5.9) :
    - chien de garde actif (WDTCON 1:16384) ;
    - gestion des erreurs SSP (SSPEN 0 puis 1, CKP, SSPOV/WCOL) et timeout
    de 50 ms ;
    - NACK quand CmdBuf est occupé ;
    - 6e octet comm_stat avec drapeau de redémarrage, ignoré par un BP
    099-37 ;
    - LED d'état.
    hard.h sélectionne le type de ce dépôt (la 1.7 sélectionnait
    TYPE_CHAMBRES partout). Sources identiques à essensys-gcc (bf38a84),
    testées sur hôte (NR-gcc-12 à -16). Aucun .hex : non qualifié avant
    NR-board-sc944d-8 et -11 sur banc.
    Feature: i2c-s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
